MrWobot/hvps/Documents/Common resistor values.png

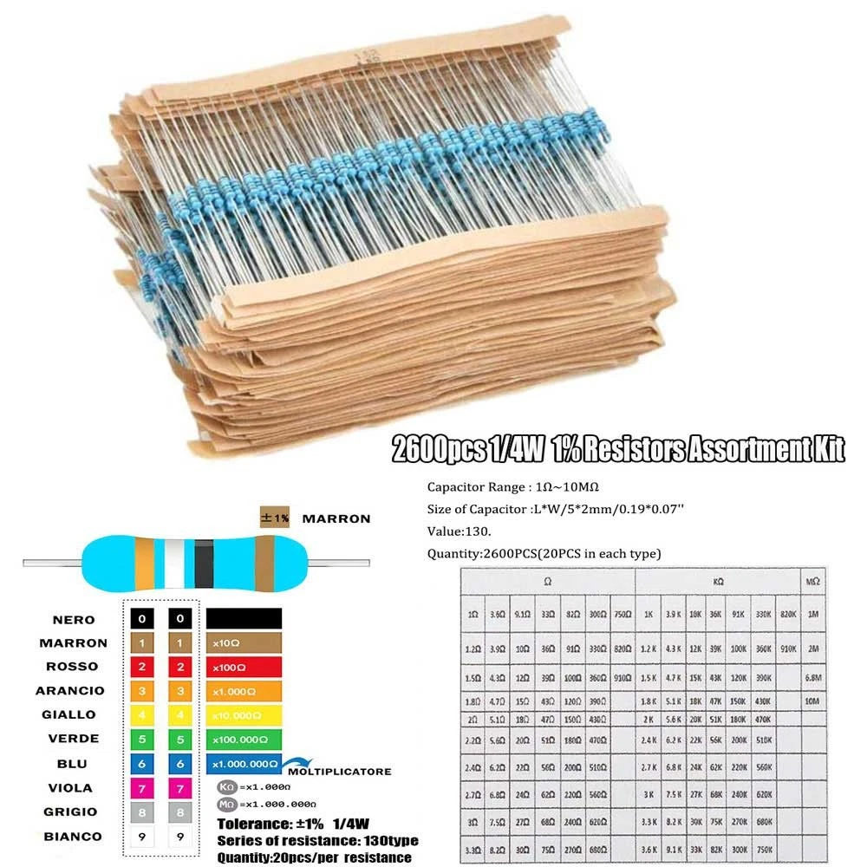
Documents/Common resistor values.png
