MrWobot/hvps/Code/C++/misc/ESP32-Pinout.webp

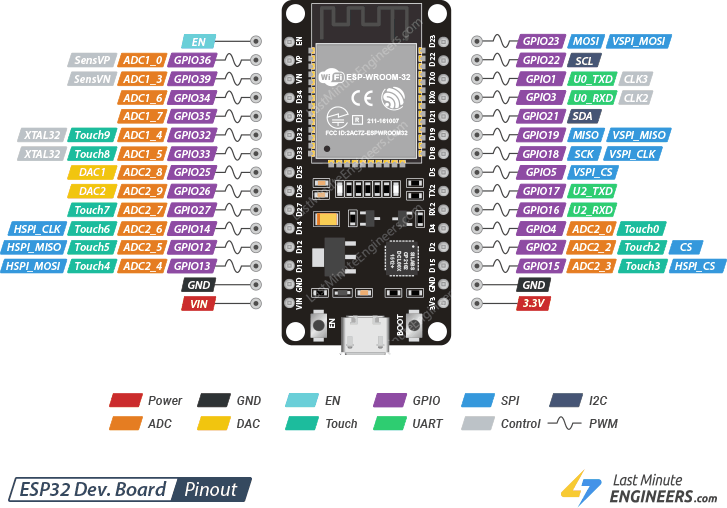
Code/C++/misc/ESP32-Pinout.webp
