MrWobot/hvps/Documents/ESP-FPGA Interface/Pins.png

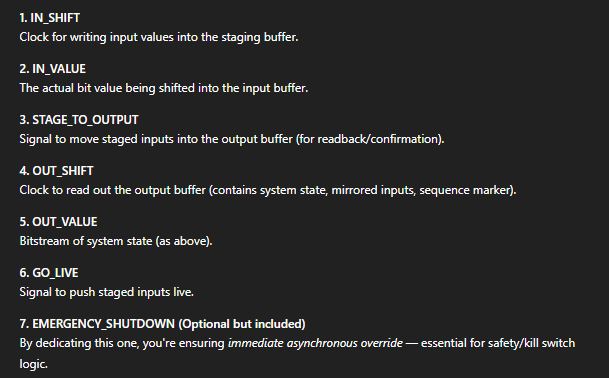
Documents/ESP-FPGA Interface/Pins.png
