MrWobot/hvps/Documents/Flyback Mismatch Ratio.png

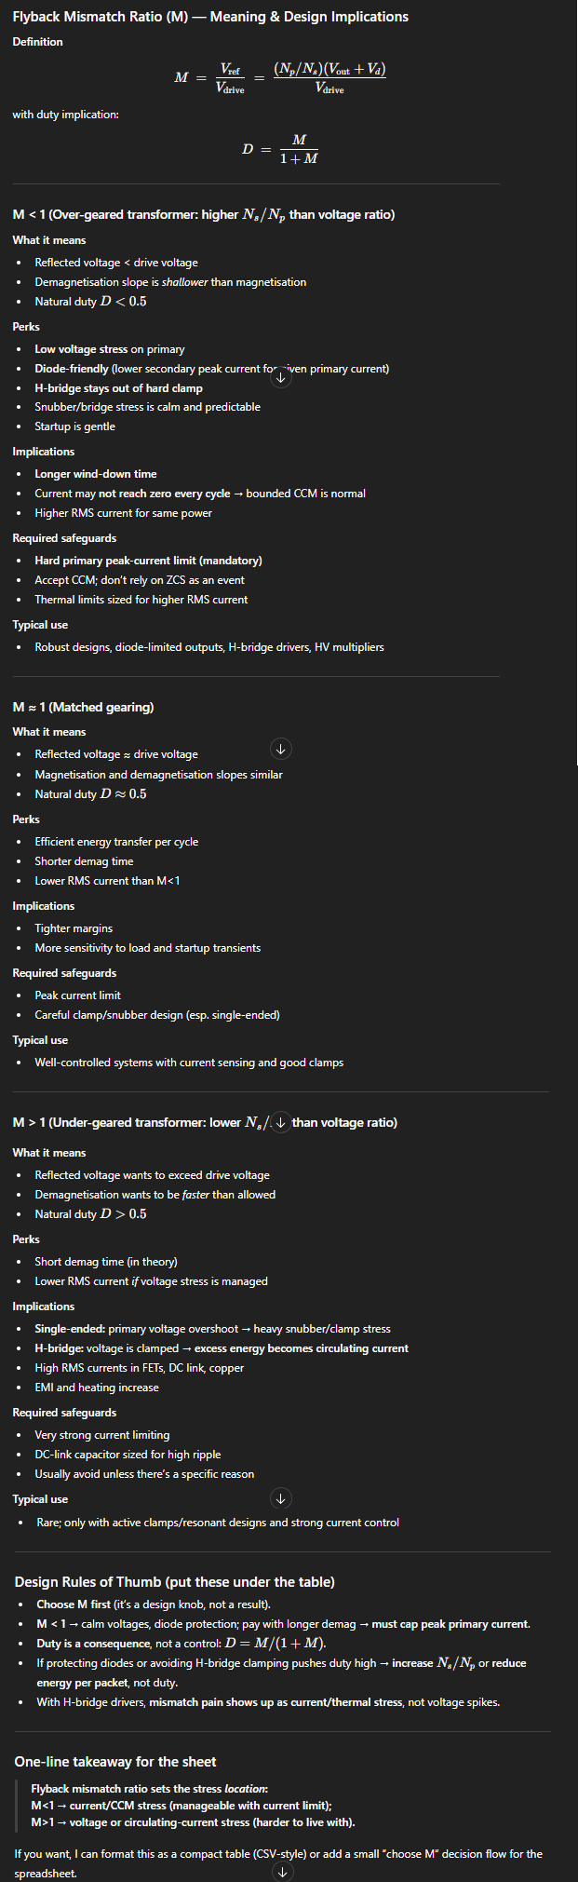
Documents/Flyback Mismatch Ratio.png
