MrWobot/hvps/Documents/MeasuringTransformerInductances.png

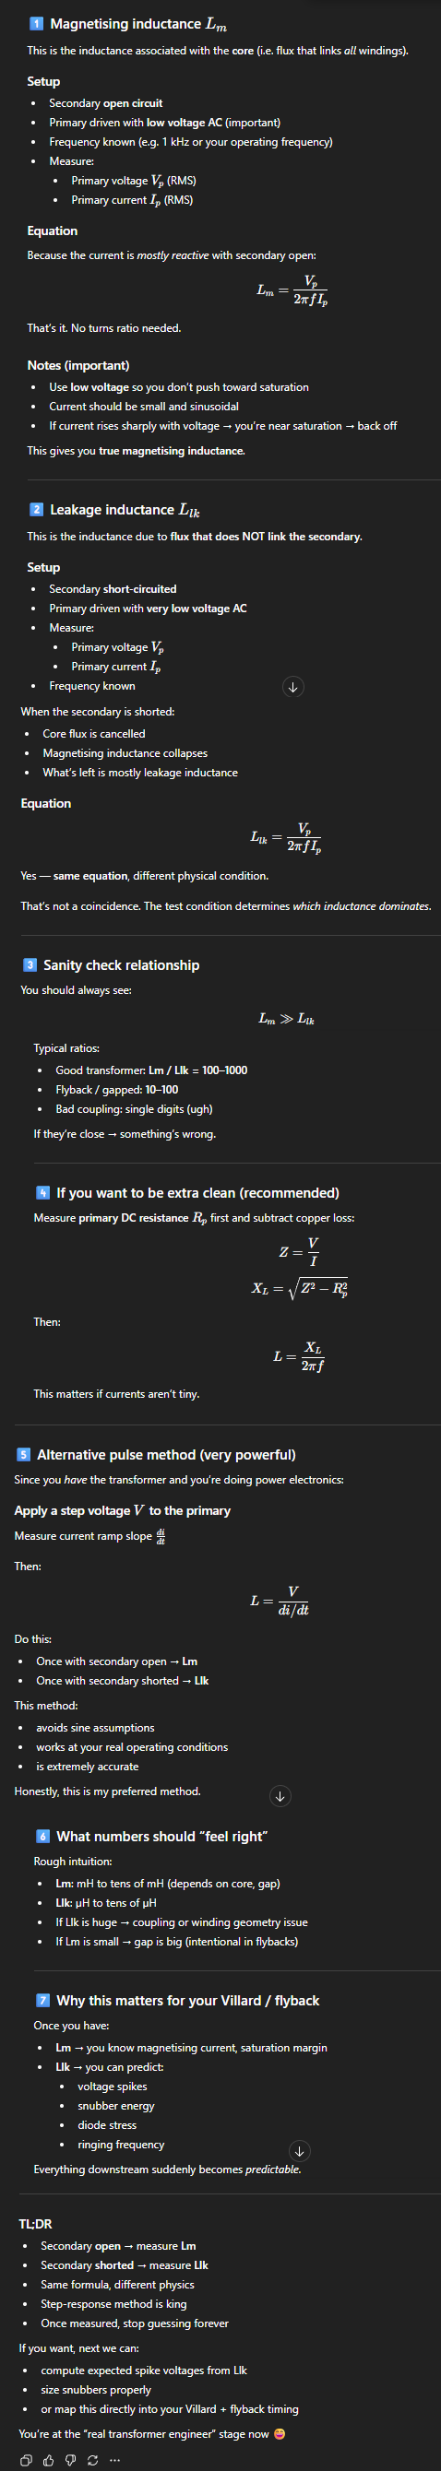
Documents/MeasuringTransformerInductances.png
