MrWobot/hvps/Kicad/HVPSController2/EP4CE6E22C8N_FPGA_Development_Board.png

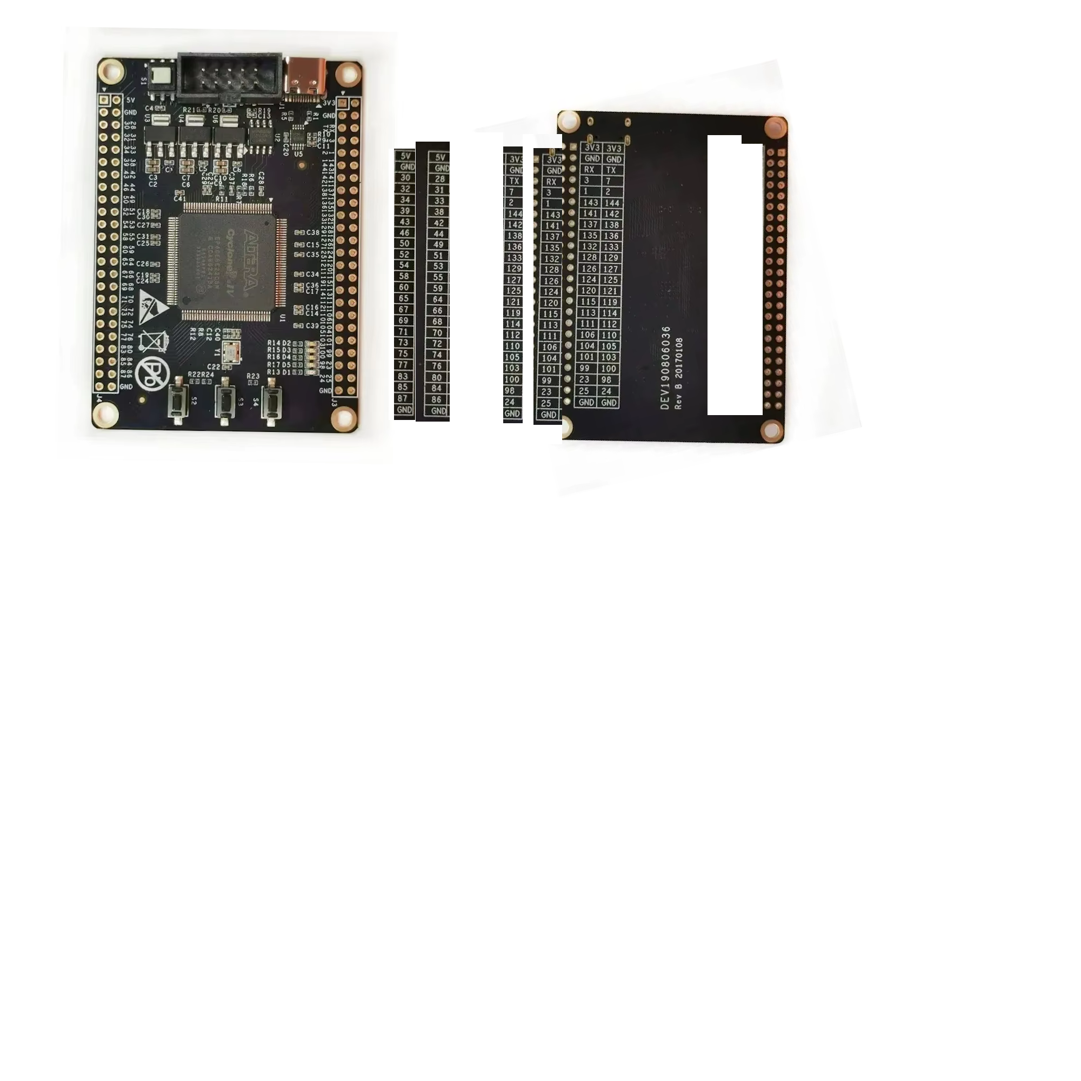
Kicad/HVPSController2/EP4CE6E22C8N_FPGA_Development_Board.png
