MrWobot/hvps/MATLAB/FullSimulation/FullSimulation.png

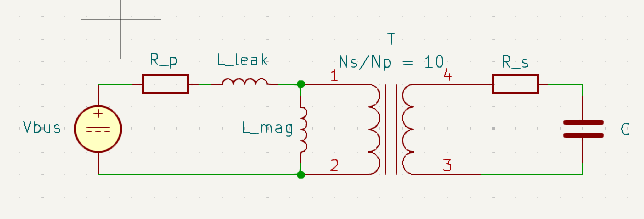
MATLAB/FullSimulation/FullSimulation.png
