MrWobot/hvps/Spreadsheets/Parts_HVPSController2.xlsx

Sheet: Sheet1
Subsystem | Reference | Ordered | Url | Include (green) | Part Name | Part Number | Category | Quantity Needed | Quantity in Stock | Description | Value/Rating | Tolerance | Voltage Rating | Power Rating | Package/Size | Supplier | Supplier Part Number | Unit Price | Total Cost | Lead Time | Notes
HVPSController2 | C1 | [/ | https://www.mouser.co.uk/ProductDetail/Chemi-Con/EKYB101ELL102MM40S?qs=IYueExuAvkrcoErCvSFiXg%3D%3D | ‎ | EKYB101ELL102MM40S | EKYB101ELL102MM40S |  |  |  | Aluminium Electrolytic Capacitors - Radial Leaded 100VDC 1000uF Tol 20% 18x40mm | 1000uF | 20% | 100v |  | 18x40mm | Mouser | 661-EKYB101E102MM40S | £1.79 | Total cost calculated as Quantity Needed × Unit Price. | Expected time for delivery from supplier. | Any additional notes, like alternatives or special instructions.
 | C2 | [/ | https://www.mouser.co.uk/ProductDetail/Chemi-Con/EKYB101ELL102MM40S?qs=IYueExuAvkrcoErCvSFiXg%3D%3D | ‎ | EKYB101ELL102MM40S | EKYB101ELL102MM40S |  |  |  | Aluminium Electrolytic Capacitors - Radial Leaded 100VDC 1000uF Tol 20% 18x40mm | 1000uF | 20% | 100v |  | 18x40mm | Mouser | 661-EKYB101E102MM40S | £1.79
 | C3 | [/ | https://www.mouser.co.uk/ProductDetail/Chemi-Con/EKYB101ELL102MM40S?qs=IYueExuAvkrcoErCvSFiXg%3D%3D | ‎ | EKYB101ELL102MM40S | EKYB101ELL102MM40S |  |  |  | Aluminium Electrolytic Capacitors - Radial Leaded 100VDC 1000uF Tol 20% 18x40mm | 1000uF | 20% | 100v |  | 18x40mm | Mouser | 661-EKYB101E102MM40S | £1.79
 | C4 | [/ | https://www.mouser.co.uk/ProductDetail/Chemi-Con/EKYB101ELL102MM40S?qs=IYueExuAvkrcoErCvSFiXg%3D%3D | ‎ | EKYB101ELL102MM40S | EKYB101ELL102MM40S |  |  |  | Aluminium Electrolytic Capacitors - Radial Leaded 100VDC 1000uF Tol 20% 18x40mm | 1000uF | 20% | 100v |  | 18x40mm | Mouser | 661-EKYB101E102MM40S | £1.79
 | C5 | [/ | https://www.mouser.co.uk/ProductDetail/Chemi-Con/EKYB101ELL102MM40S?qs=IYueExuAvkrcoErCvSFiXg%3D%3D | ‎ | EKYB101ELL102MM40S | EKYB101ELL102MM40S |  |  |  | Aluminium Electrolytic Capacitors - Radial Leaded 100VDC 1000uF Tol 20% 18x40mm | 1000uF | 20% | 100v |  | 18x40mm | Mouser | 661-EKYB101E102MM40S | £1.79
 | C6 | [/ | https://www.mouser.co.uk/ProductDetail/Chemi-Con/EKYB101ELL102MM40S?qs=IYueExuAvkrcoErCvSFiXg%3D%3D | ‎ | EKYB101ELL102MM40S | EKYB101ELL102MM40S |  |  |  | Aluminium Electrolytic Capacitors - Radial Leaded 100VDC 1000uF Tol 20% 18x40mm | 1000uF | 20% | 100v |  | 18x40mm | Mouser | 661-EKYB101E102MM40S | £1.79
 | C7 | [/ | https://www.mouser.co.uk/ProductDetail/Chemi-Con/EKYB101ELL102MM40S?qs=IYueExuAvkrcoErCvSFiXg%3D%3D | ‎ | EKYB101ELL102MM40S | EKYB101ELL102MM40S |  |  |  | Aluminium Electrolytic Capacitors - Radial Leaded 100VDC 1000uF Tol 20% 18x40mm | 1000uF | 20% | 100v |  | 18x40mm | Mouser | 661-EKYB101E102MM40S | £1.79
 | C8 | [/ | https://www.mouser.co.uk/ProductDetail/Chemi-Con/EKYB101ELL102MM40S?qs=IYueExuAvkrcoErCvSFiXg%3D%3D | ‎ | EKYB101ELL102MM40S | EKYB101ELL102MM40S |  |  |  | Aluminium Electrolytic Capacitors - Radial Leaded 100VDC 1000uF Tol 20% 18x40mm | 1000uF | 20% | 100v |  | 18x40mm | Mouser | 661-EKYB101E102MM40S | £1.79
 | C9 | [/ | https://www.mouser.co.uk/ProductDetail/Chemi-Con/EKYB101ELL102MM40S?qs=IYueExuAvkrcoErCvSFiXg%3D%3D | ‎ | EKYB101ELL102MM40S | EKYB101ELL102MM40S |  |  |  | Aluminium Electrolytic Capacitors - Radial Leaded 100VDC 1000uF Tol 20% 18x40mm | 1000uF | 20% | 100v |  | 18x40mm | Mouser | 661-EKYB101E102MM40S | £1.79
 | C10 | [/ | https://www.mouser.co.uk/ProductDetail/Chemi-Con/EKYB101ELL102MM40S?qs=IYueExuAvkrcoErCvSFiXg%3D%3D | ‎ | EKYB101ELL102MM40S | EKYB101ELL102MM40S |  |  |  | Aluminium Electrolytic Capacitors - Radial Leaded 100VDC 1000uF Tol 20% 18x40mm | 1000uF | 20% | 100v |  | 18x40mm | Mouser | 661-EKYB101E102MM40S | £1.79
 | C11 |  | https://www.aliexpress.com/item/1005002290441861.html?mp=1 | ‎ | Multilayer ceramic capacitor 50V 30pF capacitor | 300 30pF |  |  |  | 300 30oF NNKC capacitor | 30pF | 10% | 50v |  |  | Electronkit Official Store
 | C12 |  | https://www.aliexpress.com/item/1005002290441861.html?mp=1 | ‎ | Multilayer ceramic capacitor 50V 30pF capacitor | 300 30pF |  |  |  | 300 30oF NNKC capacitor | 30pF | 10% | 50v |  |  | Electronkit Official Store
 | C13 |  | https://www.aliexpress.com/item/1005002290441861.html?mp=1 | ‎ | Multilayer ceramic capacitor 50V 30pF capacitor | 300 30pF |  |  |  | 300 30oF NNKC capacitor | 30pF | 10% | 50v |  |  | Electronkit Official Store
 | C14 |  | https://www.aliexpress.com/item/1005002290441861.html?mp=1 | ‎ | Multilayer ceramic capacitor 50V 30pF capacitor | 300 30pF |  |  |  | 300 30oF NNKC capacitor | 30pF | 10% | 50v |  |  | Electronkit Official Store
 | C15 |  | https://www.aliexpress.com/item/1005002290441861.html?mp=1 | ‎ | Multilayer ceramic capacitor 50V 30pF capacitor | 300 30pF |  |  |  | 300 30oF NNKC capacitor | 30pF | 10% | 50v |  |  | Electronkit Official Store
 | C16 |  | https://www.aliexpress.com/item/1005002290441861.html?mp=1 | ‎ | Multilayer ceramic capacitor 50V 30pF capacitor | 300 30pF |  |  |  | 300 30oF NNKC capacitor | 30pF | 10% | 50v |  |  | Electronkit Official Store
 | C17 |  | https://www.aliexpress.com/item/1005002290441861.html?curPageLogUid=F0H9fgmOu6Th | ‎ | Multilayer ceramic capacitor 50V 100nF capacitor | 104 100nF |  |  |  | 104 100nF MMLC capacitor | 100nF | 10% | 50v |  |  | Electronkit Official Store
 | C18 |  | https://www.aliexpress.com/item/1005002290441861.html?curPageLogUid=F0H9fgmOu6Th | ‎ | Multilayer ceramic capacitor 50V 100nF capacitor | 104 100nF |  |  |  | 104 100nF MMLC capacitor | 100nF | 10% | 50v |  |  | Electronkit Official Store
 | C19 |  | https://www.aliexpress.com/item/1005002290441861.html?curPageLogUid=F0H9fgmOu6Th | ‎ | Multilayer ceramic capacitor 50V 100nF capacitor | 104 100nF |  |  |  | 104 100nF MMLC capacitor | 100nF | 10% | 50v |  |  | Electronkit Official Store
 | C20 |  | https://www.aliexpress.com/item/1005002290441861.html?curPageLogUid=F0H9fgmOu6Th | ‎ | Multilayer ceramic capacitor 50V 100nF capacitor | 104 100nF |  |  |  | 104 100nF MMLC capacitor | 100nF | 10% | 50v |  |  | Electronkit Official Store
 | C21 |  | https://www.aliexpress.com/item/1005002290441861.html?curPageLogUid=F0H9fgmOu6Th | ‎ | Multilayer ceramic capacitor 50V 100nF capacitor | 104 100nF |  |  |  | 104 100nF MMLC capacitor | 100nF | 10% | 50v |  |  | Electronkit Official Store
 | C22 |  | https://www.aliexpress.com/item/1005002290441861.html?curPageLogUid=F0H9fgmOu6Th | ‎ | Multilayer ceramic capacitor 50V 100nF capacitor | 104 100nF |  |  |  | 104 100nF MMLC capacitor | 100nF | 10% | 50v |  |  | Electronkit Official Store
 | C23 |  | https://www.aliexpress.com/item/1005002290441861.html?curPageLogUid=F0H9fgmOu6Th | ‎ | Multilayer ceramic capacitor 50V 100nF capacitor | 104 100nF |  |  |  | 104 100nF MMLC capacitor | 100nF | 10% | 50v |  |  | Electronkit Official Store
 | C24 |  | https://www.aliexpress.com/item/1005002290441861.html?curPageLogUid=F0H9fgmOu6Th | ‎ | Multilayer ceramic capacitor 50V 100nF capacitor | 104 100nF |  |  |  | 104 100nF MMLC capacitor | 100nF | 10% | 50v |  |  | Electronkit Official Store
 | C25 |  | https://www.aliexpress.com/item/1005002290441861.html?curPageLogUid=F0H9fgmOu6Th | ‎ | Multilayer ceramic capacitor 50V 100nF capacitor | 104 100nF |  |  |  | 104 100nF MMLC capacitor | 100nF | 10% | 50v |  |  | Electronkit Official Store
 | C26 |  | https://www.aliexpress.com/item/1005002290441861.html?curPageLogUid=F0H9fgmOu6Th | ‎ | Multilayer ceramic capacitor 50V 100nF capacitor | 104 100nF |  |  |  | 104 100nF MMLC capacitor | 100nF | 10% | 50v |  |  | Electronkit Official Store
 | C27 |  | https://www.aliexpress.com/item/1005002290441861.html?curPageLogUid=F0H9fgmOu6Th | ‎ | Multilayer ceramic capacitor 50V 100nF capacitor | 104 100nF |  |  |  | 104 100nF MMLC capacitor | 100nF | 10% | 50v |  |  | Electronkit Official Store
 | C28 | [/ | https://www.mouser.co.uk/ProductDetail/Chemi-Con/EKYB101ELL102MM40S?qs=IYueExuAvkrcoErCvSFiXg%3D%3D | ‎ | EKYB101ELL102MM40S | EKYB101ELL102MM40S |  |  |  | Aluminium Electrolytic Capacitors - Radial Leaded 100VDC 1000uF Tol 20% 18x40mm | 1000uF | 20% | 100v |  | 18x40mm | Mouser | 661-EKYB101E102MM40S | £1.79
 | C29 | [/ | https://www.mouser.co.uk/ProductDetail/Chemi-Con/EKYB101ELL102MM40S?qs=IYueExuAvkrcoErCvSFiXg%3D%3D | ‎ | EKYB101ELL102MM40S | EKYB101ELL102MM40S |  |  |  | Aluminium Electrolytic Capacitors - Radial Leaded 100VDC 1000uF Tol 20% 18x40mm | 1000uF | 20% | 100v |  | 18x40mm | Mouser | 661-EKYB101E102MM40S | £1.79
 | C30 | [/ | https://www.mouser.co.uk/ProductDetail/Chemi-Con/EKYB101ELL102MM40S?qs=IYueExuAvkrcoErCvSFiXg%3D%3D | ‎ | EKYB101ELL102MM40S | EKYB101ELL102MM40S |  |  |  | Aluminium Electrolytic Capacitors - Radial Leaded 100VDC 1000uF Tol 20% 18x40mm | 1000uF | 20% | 100v |  | 18x40mm | Mouser | 661-EKYB101E102MM40S | £1.79
 | C31 | [/ | https://www.mouser.co.uk/ProductDetail/Chemi-Con/EKYB101ELL102MM40S?qs=IYueExuAvkrcoErCvSFiXg%3D%3D | ‎ | EKYB101ELL102MM40S | EKYB101ELL102MM40S |  |  |  | Aluminium Electrolytic Capacitors - Radial Leaded 100VDC 1000uF Tol 20% 18x40mm | 1000uF | 20% | 100v |  | 18x40mm | Mouser | 661-EKYB101E102MM40S | £1.79
 | C32 | [/ | https://www.mouser.co.uk/ProductDetail/Chemi-Con/EKYB101ELL102MM40S?qs=IYueExuAvkrcoErCvSFiXg%3D%3D | ‎ | EKYB101ELL102MM40S | EKYB101ELL102MM40S |  |  |  | Aluminium Electrolytic Capacitors - Radial Leaded 100VDC 1000uF Tol 20% 18x40mm | 1000uF | 20% | 100v |  | 18x40mm | Mouser | 661-EKYB101E102MM40S | £1.79
 | C33 | [/ | https://www.mouser.co.uk/ProductDetail/Chemi-Con/EKYB101ELL102MM40S?qs=IYueExuAvkrcoErCvSFiXg%3D%3D | ‎ | EKYB101ELL102MM40S | EKYB101ELL102MM40S |  |  |  | Aluminium Electrolytic Capacitors - Radial Leaded 100VDC 1000uF Tol 20% 18x40mm | 1000uF | 20% | 100v |  | 18x40mm | Mouser | 661-EKYB101E102MM40S | £1.79
 | C34 | [/ | https://www.mouser.co.uk/ProductDetail/Chemi-Con/EKYB101ELL102MM40S?qs=IYueExuAvkrcoErCvSFiXg%3D%3D | ‎ | EKYB101ELL102MM40S | EKYB101ELL102MM40S |  |  |  | Aluminium Electrolytic Capacitors - Radial Leaded 100VDC 1000uF Tol 20% 18x40mm | 1000uF | 20% | 100v |  | 18x40mm | Mouser | 661-EKYB101E102MM40S | £1.79
 | C35 | [/ | https://www.mouser.co.uk/ProductDetail/Chemi-Con/EKYB101ELL102MM40S?qs=IYueExuAvkrcoErCvSFiXg%3D%3D | ‎ | EKYB101ELL102MM40S | EKYB101ELL102MM40S |  |  |  | Aluminium Electrolytic Capacitors - Radial Leaded 100VDC 1000uF Tol 20% 18x40mm | 1000uF | 20% | 100v |  | 18x40mm | Mouser | 661-EKYB101E102MM40S | £1.79
 | C36 | [/ | https://www.mouser.co.uk/ProductDetail/Chemi-Con/EKYB101ELL102MM40S?qs=IYueExuAvkrcoErCvSFiXg%3D%3D | ‎ | EKYB101ELL102MM40S | EKYB101ELL102MM40S |  |  |  | Aluminium Electrolytic Capacitors - Radial Leaded 100VDC 1000uF Tol 20% 18x40mm | 1000uF | 20% | 100v |  | 18x40mm | Mouser | 661-EKYB101E102MM40S | £1.79
 | C37 | [/ | https://www.mouser.co.uk/ProductDetail/Chemi-Con/EKYB101ELL102MM40S?qs=IYueExuAvkrcoErCvSFiXg%3D%3D | ‎ | EKYB101ELL102MM40S | EKYB101ELL102MM40S |  |  |  | Aluminium Electrolytic Capacitors - Radial Leaded 100VDC 1000uF Tol 20% 18x40mm | 1000uF | 20% | 100v |  | 18x40mm | Mouser | 661-EKYB101E102MM40S | £1.79
 | C38 | [/ | https://www.mouser.co.uk/ProductDetail/KYOCERA-AVX/SL155C472MAB | ‎ | SL155C472MAB | SL155C472MAB |  |  |  | Multilayer Ceramic Capacitors MLCC - Leaded SKYCAPS | 4.7uF | 10% | 50v |  |  | Mouser | 581-SL155C472MAB | £0.31
 | C39 |  |  | /
 | C40 | [/ | https://www.mouser.co.uk/ProductDetail/Vishay-BC-Components/K103K15X7RF5TK2?qs=sYfpZ29HcUSZbtKxC8Ci1g%3D%3D | ‎ | K103K15X7RF5TK2 | K103K15X7RF5TK2 |  |  |  | Multilayer Ceramic Capacitors MLCC - Leaded .1LS .01UF 50V 10% | 10nF | 10% | 50v |  |  | Mouser | 594-K103K15X7RF5TK2 | £0.18
 | C41 |  | https://www.mouser.co.uk/ProductDetail/Panasonic/ECA-1JM102?qs=EZwXiknEaqTHw%252BmBjjudqg%3D%3D | ‎ | ECA-1JM102 | ECA-1JM102 |  |  |  | Aluminium Electrolytic Capacitors - Radial Leaded 1000uF 63V | 1000uF | 20% | 63v |  |  | Mouser | 667-ECA-1JM102 | £0.68
 | C42 |  | https://www.mouser.co.uk/ProductDetail/KYOCERA-AVX/SR211C104KAATR1 | ‎ | SR211C104KAATR1 | SR211C104KAATR1 |  |  |  | Multilayer Ceramic Capacitors MLCC - Leaded 100V 0.1uF X7R Long Leads 1"min 10% A 581-SR211C104KARTR1 | 100nF | 10% | 100v |  |  | Mouser | 581-SR211C104KAATR1
 | C43 |  | https://www.mouser.co.uk/ProductDetail/Nichicon/UPW1E471MPD6TA?qs=%252Bj3bNAeznFUL2kyej8zyGg%3D%3D | ‎ | UPW1E471MPD6TA | UPW1E471MPD6TA |  |  |  | Aluminium Electrolytic Capacitors - Radial Leaded 470uF 20% 25V AEC-Q200 | 470uF | 20% | 25v |  |  | Mouser | 647-UPW1E471MPD6TA | £0.29
 | C44 |  | https://www.aliexpress.com/item/1005002290441861.html?curPageLogUid=F0H9fgmOu6Th | ‎ | Multilayer ceramic capacitor 50V 100nF capacitor | 104 100nF |  |  |  | 104 100nF MMLC capacitor | 100nF | 10% | 50v |  |  | Electronkit Official Store
 | C45 | [/ | https://www.mouser.co.uk/ProductDetail/KYOCERA-AVX/SR211C104KAATR1 | ‎ | SR211C104KAATR1 | SR211C104KAATR1 |  |  |  | Multilayer Ceramic Capacitors MLCC - Leaded 100V 0.1uF X7R Long Leads 1"min 10% A 581-SR211C104KARTR1 | 100nF | 10% | 100v |  |  | Mouser | 581-SR211C104KAATR1
 | C46 | [/ | https://www.mouser.co.uk/ProductDetail/KYOCERA-AVX/SR211C104KAATR1 | ‎ | SR211C104KAATR1 | SR211C104KAATR1 |  |  |  | Multilayer Ceramic Capacitors MLCC - Leaded 100V 0.1uF X7R Long Leads 1"min 10% A 581-SR211C104KARTR1 | 100nF | 10% | 100v |  |  | Mouser | 581-SR211C104KAATR1
 | C47 | [/ | https://www.mouser.co.uk/ProductDetail/TDK/FK16X7R1C106K?qs=zLBlM7QTTNo2fF6bge9DGw%3D%3D | ‎ | FK16X7R1C106K | FK16X7R1C106K |  |  |  | Multilayer Ceramic Capacitors MLCC - Leaded SUGGESTED ALTERNATE 810-FG16X7R1E106KRT6 | 10uF | 10% | 16v |  |  | Mouser | 810-FK16X7R1C106K | £0.38
 | C48 |  |  |  |  |  |  |  |  |  | 4.7nF
 | C49 |  | https://www.mouser.co.uk/ProductDetail/Panasonic/ECA-1JM102?qs=EZwXiknEaqTHw%252BmBjjudqg%3D%3D | ‎ | ECA-1JM102 | ECA-1JM102 |  |  |  | Aluminium Electrolytic Capacitors - Radial Leaded 1000uF 63V | 1000uF | 20% | 63v |  |  | Mouser | 667-ECA-1JM102 | £0.68
 | C50 |  | https://www.mouser.co.uk/ProductDetail/KYOCERA-AVX/SR211C104KAATR1 | ‎ | SR211C104KAATR1 | SR211C104KAATR1 |  |  |  | Multilayer Ceramic Capacitors MLCC - Leaded 100V 0.1uF X7R Long Leads 1"min 10% A 581-SR211C104KARTR1 | 100nF | 10% | 100v |  |  | Mouser | 581-SR211C104KAATR1
 | C51 |  | https://www.mouser.co.uk/ProductDetail/Nichicon/UPW1E471MPD6TA?qs=%252Bj3bNAeznFUL2kyej8zyGg%3D%3D | ‎ | UPW1E471MPD6TA | UPW1E471MPD6TA |  |  |  | Aluminium Electrolytic Capacitors - Radial Leaded 470uF 20% 25V AEC-Q200 | 470uF | 20% | 25v |  |  | Mouser | 647-UPW1E471MPD6TA | £0.29
 | C52 |  | https://www.aliexpress.com/item/1005002290441861.html?curPageLogUid=F0H9fgmOu6Th |  | Multilayer ceramic capacitor 50V 100nF capacitor | 104 100nF |  |  |  | 104 100nF MMLC capacitor | 100nF | 10% | 50v |  |  | Electronkit Official Store
 | C53
 | C54 | [/ | https://www.mouser.co.uk/ProductDetail/KYOCERA-AVX/SR211C104KAATR1 | ‎ | SR211C104KAATR1 | SR211C104KAATR1 |  |  |  | Multilayer Ceramic Capacitors MLCC - Leaded 100V 0.1uF X7R Long Leads 1"min 10% A 581-SR211C104KARTR1 | 100nF | 10% | 100v |  |  | Mouser | 581-SR211C104KAATR1
 | C55 | [/ | https://www.mouser.co.uk/ProductDetail/KYOCERA-AVX/SR211C104KAATR1 | ‎ | SR211C104KAATR1 | SR211C104KAATR1 |  |  |  | Multilayer Ceramic Capacitors MLCC - Leaded 100V 0.1uF X7R Long Leads 1"min 10% A 581-SR211C104KARTR1 | 100nF | 10% | 100v |  |  | Mouser | 581-SR211C104KAATR1
 | C56 | [/ | https://www.mouser.co.uk/ProductDetail/TDK/FK16X7R1C106K?qs=zLBlM7QTTNo2fF6bge9DGw%3D%3D | ‎ | FK16X7R1C106K | FK16X7R1C106K |  |  |  | Multilayer Ceramic Capacitors MLCC - Leaded SUGGESTED ALTERNATE 810-FG16X7R1E106KRT6 | 10uF | 10% | 16v |  |  | Mouser | 810-FK16X7R1C106K | £0.38
 | C57
 | C58 |  | https://www.mouser.co.uk/ProductDetail/Panasonic/ECA-1JM102?qs=EZwXiknEaqTHw%252BmBjjudqg%3D%3D | ‎ | ECA-1JM102 | ECA-1JM102 |  |  |  | Aluminium Electrolytic Capacitors - Radial Leaded 1000uF 63V | 1000uF | 20% | 63v |  |  | Mouser | 667-ECA-1JM102 | £0.68
 | C59 |  | https://www.mouser.co.uk/ProductDetail/KYOCERA-AVX/SR211C104KAATR1 | ‎ | SR211C104KAATR1 | SR211C104KAATR1 |  |  |  | Multilayer Ceramic Capacitors MLCC - Leaded 100V 0.1uF X7R Long Leads 1"min 10% A 581-SR211C104KARTR1 | 100nF | 10% | 100v |  |  | Mouser | 581-SR211C104KAATR1
 | C60 |  |  | ‎
 | C61 |  |  | ‎ |  |  |  |  |  |  |  |  |  |  |  | Mouser | 647-UPW1E471MPD6TA | £0.29
 | C62 |  | https://www.mouser.co.uk/ProductDetail/Nichicon/UPW1E471MPD6TA?qs=%252Bj3bNAeznFUL2kyej8zyGg%3D%3D | ‎ | UPW1E471MPD6TA | UPW1E471MPD6TA |  |  |  | Aluminium Electrolytic Capacitors - Radial Leaded 470uF 20% 25V AEC-Q200 | 470uF | 20% | 25v
 | C63 |  | https://www.aliexpress.com/item/1005002290441861.html?curPageLogUid=F0H9fgmOu6Th | ‎ | Multilayer ceramic capacitor 50V 100nF capacitor | 104 100nF |  |  |  | 104 100nF MMLC capacitor | 100nF | 10% | 50v |  |  | Electronkit Official Store
 | C64 | [/ | https://www.mouser.co.uk/ProductDetail/KYOCERA-AVX/SR211C104KAATR1 | ‎ | SR211C104KAATR1 | SR211C104KAATR1 |  |  |  | Multilayer Ceramic Capacitors MLCC - Leaded 100V 0.1uF X7R Long Leads 1"min 10% A 581-SR211C104KARTR1 | 100nF | 10% | 100v |  |  | Mouser | 581-SR211C104KAATR1
 | C65 | [/ | https://www.mouser.co.uk/ProductDetail/KYOCERA-AVX/SR211C104KAATR1 | ‎ | SR211C104KAATR1 | SR211C104KAATR1 |  |  |  | Multilayer Ceramic Capacitors MLCC - Leaded 100V 0.1uF X7R Long Leads 1"min 10% A 581-SR211C104KARTR1 | 100nF | 10% | 100v |  |  | Mouser | 581-SR211C104KAATR1
 | C66 | [/ | https://www.mouser.co.uk/ProductDetail/TDK/FK16X7R1C106K?qs=zLBlM7QTTNo2fF6bge9DGw%3D%3D | ‎ | FK16X7R1C106K | FK16X7R1C106K |  |  |  | Multilayer Ceramic Capacitors MLCC - Leaded SUGGESTED ALTERNATE 810-FG16X7R1E106KRT6 | 10uF | 10% | 16v |  |  | Mouser | 810-FK16X7R1C106K | £0.38
 | C67 | [/ | https://www.mouser.co.uk/ProductDetail/TDK/FG26X7R2A105KNT06?qs=qf2ddTMq67XO0I1H0ed67A%3D%3D | ‎ | FG26X7R2A105KNT06 | FG26X7R2A105KNT06 |  |  |  | Multilayer Ceramic Capacitors MLCC - Leaded RAD 100V 1uF X7R 10% LS:5mm | 1uF | 10% | 100v |  |  | Mouser | 810-FG26X7R2A105KNT6 | £0.56
 | C68 | [/ | https://www.mouser.co.uk/ProductDetail/TDK/FG26X7R2A105KNT06?qs=qf2ddTMq67XO0I1H0ed67A%3D%3D | ‎ | FG26X7R2A105KNT06 | FG26X7R2A105KNT06 |  |  |  | Multilayer Ceramic Capacitors MLCC - Leaded RAD 100V 1uF X7R 10% LS:5mm | 1uF | 10% | 100v |  |  | Mouser | 810-FG26X7R2A105KNT6 | £0.56
 | C69 |  | https://www.aliexpress.com/item/1005002290441861.html?curPageLogUid=F0H9fgmOu6Th | ‎ | Multilayer ceramic capacitor 50V 100nF capacitor | 104 100nF |  |  |  | 104 100nF MMLC capacitor | 100nF | 10% | 50v |  |  | Electronkit Official Store
 | C70 | [/ | https://www.mouser.co.uk/ProductDetail/TDK/FK16X7R1C106K?qs=zLBlM7QTTNo2fF6bge9DGw%3D%3D | ‎ | FK16X7R1C106K | FK16X7R1C106K |  |  |  | Multilayer Ceramic Capacitors MLCC - Leaded SUGGESTED ALTERNATE 810-FG16X7R1E106KRT6 | 10uF | 10% | 16v |  |  | Mouser | 810-FK16X7R1C106K | £0.38
 | C71 |  | https://www.aliexpress.com/item/1005002290441861.html?curPageLogUid=F0H9fgmOu6Th | ‎ | Multilayer ceramic capacitor 50V 100nF capacitor | 104 100nF |  |  |  | 104 100nF MMLC capacitor | 100nF | 10% | 50v |  |  | Electronkit Official Store
 | C72 | [/ | https://www.mouser.co.uk/ProductDetail/TDK/FK16X7R1C106K?qs=zLBlM7QTTNo2fF6bge9DGw%3D%3D | ‎ | FK16X7R1C106K | FK16X7R1C106K |  |  |  | Multilayer Ceramic Capacitors MLCC - Leaded SUGGESTED ALTERNATE 810-FG16X7R1E106KRT6 | 10uF | 10% | 16v |  |  | Mouser | 810-FK16X7R1C106K | £0.38
 | C73 | [/ | https://www.mouser.co.uk/ProductDetail/TDK/FG26X7R2A105KNT06?qs=qf2ddTMq67XO0I1H0ed67A%3D%3D | ‎ | FG26X7R2A105KNT06 | FG26X7R2A105KNT06 |  |  |  | Multilayer Ceramic Capacitors MLCC - Leaded RAD 100V 1uF X7R 10% LS:5mm | 1uF | 10% | 100v |  |  | Mouser | 810-FG26X7R2A105KNT6 | £0.56
 | C74 | [/ | https://www.mouser.co.uk/ProductDetail/TDK/FG26X7R2A105KNT06?qs=qf2ddTMq67XO0I1H0ed67A%3D%3D | ‎ | FG26X7R2A105KNT06 | FG26X7R2A105KNT06 |  |  |  | Multilayer Ceramic Capacitors MLCC - Leaded RAD 100V 1uF X7R 10% LS:5mm | 1uF | 10% | 100v |  |  | Mouser | 810-FG26X7R2A105KNT6 | £0.56
 | C75 |  |  | /
 | C76 |  |  | /
 | C77 |  |  | /
 | C78 |  |  | /
 | C81 |  | https://www.aliexpress.com/item/1005002290441861.html?curPageLogUid=F0H9fgmOu6Th | ‎ | Multilayer ceramic capacitor 50V 100nF capacitor | 104 100nF |  |  |  | 104 100nF MMLC capacitor | 100nF | 10% | 50v |  |  | Electronkit Official Store
 | C82 |  | https://www.aliexpress.com/item/1005002290441861.html?curPageLogUid=F0H9fgmOu6Th | ‎ | Multilayer ceramic capacitor 50V 100nF capacitor | 104 100nF |  |  |  | 104 100nF MMLC capacitor | 100nF | 10% | 50v |  |  | Electronkit Official Store
 | D1 |  |  |  | 1N4148 | 1n4148 |  |  |  | 1N4148
 | D2 |  |  |  | 1N4148 | 1n4148 |  |  |  | 1N4148
 | D3 |  |  |  | 1N4148 | 1n4148 |  |  |  | 1N4148
 | D4 | [/ | https://www.mouser.co.uk/ProductDetail/Vishay-Semiconductors/BZX55C3V0-TR?qs=WLTup5mM6hj0XdtrqBFixA%3D%3D3D | ‎ | BZX55C3V0-TR | BZX55C3V0-TR |  |  |  | Zener Diodes 3.0 Volt 0.5W 5% |  |  |  |  |  | Mouser | 78-BZX55C3V0
 | D5 |  | https://www.mouser.co.uk/ProductDetail/STMicroelectronics/1N5822?qs=JV7lzlMm3yJ50hlrGV6%252BnQ%3D%3D | ‎ | 1N5822 | 1N5822 |  |  |  | Schottky Diodes & Rectifiers Vr/40V Io/3A BULK |  |  |  |  |  | Mouser | 511-1N5822 | £0.21
 | D6 | [/ | https://www.mouser.co.uk/ProductDetail/onsemi/1N4149?qs=i4Fj9T%2FoRm%2FvLHm7C0TH8w%3D%3D | ‎ | 1N4149 | 1N4149 |  |  |  | Small Signal Switching Diodes Hi Conductance Fast |  |  |  |  |  | Mouser | 512-1N4149 | £0.07
 | D7 | [/ | https://www.mouser.co.uk/ProductDetail/onsemi/1N4149?qs=i4Fj9T%2FoRm%2FvLHm7C0TH8w%3D%3D | ‎ | 1N4149 | 1N4149 |  |  |  | Small Signal Switching Diodes Hi Conductance Fast |  |  |  |  |  | Mouser | 512-1N4149 | £0.07
 | D8 | [/ | https://www.mouser.co.uk/ProductDetail/onsemi/1N4149?qs=i4Fj9T%2FoRm%2FvLHm7C0TH8w%3D%3D | ‎ | 1N4149 | 1N4149 |  |  |  | Small Signal Switching Diodes Hi Conductance Fast |  |  |  |  |  | Mouser | 512-1N4149 | £0.07
 | D9 | [/ | https://www.mouser.co.uk/ProductDetail/onsemi/1N4149?qs=i4Fj9T%2FoRm%2FvLHm7C0TH8w%3D%3D | ‎ | 1N4149 | 1N4149 |  |  |  | Small Signal Switching Diodes Hi Conductance Fast |  |  |  |  |  | Mouser | 512-1N4149 | £0.07
 | D10 |  | https://www.mouser.co.uk/ProductDetail/STMicroelectronics/1N5822?qs=JV7lzlMm3yJ50hlrGV6%252BnQ%3D%3D | ‎ | 1N5822 | 1N5822 |  |  |  | Schottky Diodes & Rectifiers Vr/40V Io/3A BULK |  |  |  |  |  | Mouser | 511-1N5822 | £0.21
 | D11 | [/ | https://www.mouser.co.uk/ProductDetail/onsemi/1N4149?qs=i4Fj9T%2FoRm%2FvLHm7C0TH8w%3D%3D | ‎ | 1N4149 | 1N4149 |  |  |  | Small Signal Switching Diodes Hi Conductance Fast |  |  |  |  |  | Mouser | 512-1N4149 | £0.07
 | D12 | [/ | https://www.mouser.co.uk/ProductDetail/onsemi/1N4149?qs=i4Fj9T%2FoRm%2FvLHm7C0TH8w%3D%3D | ‎ | 1N4149 | 1N4149 |  |  |  | Small Signal Switching Diodes Hi Conductance Fast |  |  |  |  |  | Mouser | 512-1N4149 | £0.07
 | D13 |  | https://www.mouser.co.uk/ProductDetail/STMicroelectronics/1N5822?qs=JV7lzlMm3yJ50hlrGV6%252BnQ%3D%3D | ‎ | 1N5822 | 1N5822 |  |  |  | Schottky Diodes & Rectifiers Vr/40V Io/3A BULK |  |  |  |  |  | Mouser | 511-1N5822 | £0.21
 | D14 | [/ | https://www.mouser.co.uk/ProductDetail/Taiwan-Semiconductor/MUR420-R0?qs=dv9KMQQLqv0Mtply6g8TSg%3D%3D | ‎ | MUR420 R0 | MUR420 R0 |  |  |  | Rectifiers 25ns 4A 200V Ultra F ast Recovery Rect |  |  |  |  |  | Mouser | 821-MUR420R0 | £0.73
 | D15 | [/ | https://www.mouser.co.uk/ProductDetail/Taiwan-Semiconductor/MUR420-R0?qs=dv9KMQQLqv0Mtply6g8TSg%3D%3D | ‎ | MUR420 R0 | MUR420 R0 |  |  |  | Rectifiers 25ns 4A 200V Ultra F ast Recovery Rect |  |  |  |  |  | Mouser | 821-MUR420R0 | £0.73
 | D16 |  |  |  | 1N4148 | 1n4148 |  |  |  | 1N4148
 | F1 | [/ | https://www.mouser.co.uk/ProductDetail/Essentra/FH-320-NV?qs=PzGy0jfpSMtU9GQhdYJRvA%3D%3D | ‎ | FH-320-NV | FH-320-NV |  |  |  | Fuse Holder Accessories Fuse Holder,Black,5X20 Fuse |  |  |  |  |  | Mouser | 144-FH-320-NV | £0.72
 | H1 | [/ | https://www.mouser.co.uk/ProductDetail/Wakefield-Thermal/647-25ABPE?qs=1%252ByrAFyf4wEF4vm1j%252Byz0w%3D%3D | ‎ | 647-25ABPE | 647-25ABPE |  |  |  | Heat Sinks High Performance Heat Sink for Vertical Board Mounting for TO-220, 63.5mm Height |  |  |  |  |  | Mouser | 567-647-25ABPE | £2.55
 | H2 | [/ | https://www.mouser.co.uk/ProductDetail/Wakefield-Thermal/647-25ABPE?qs=1%252ByrAFyf4wEF4vm1j%252Byz0w%3D%3D | ‎ | 647-25ABPE | 647-25ABPE |  |  |  | Heat Sinks High Performance Heat Sink for Vertical Board Mounting for TO-220, 63.5mm Height |  |  |  |  |  | Mouser | 567-647-25ABPE | £2.55
 | H3 | [/ | https://www.mouser.co.uk/ProductDetail/Wakefield-Thermal/647-25ABPE?qs=1%252ByrAFyf4wEF4vm1j%252Byz0w%3D%3D | ‎ | 647-25ABPE | 647-25ABPE |  |  |  | Heat Sinks High Performance Heat Sink for Vertical Board Mounting for TO-220, 63.5mm Height |  |  |  |  |  | Mouser | 567-647-25ABPE | £2.55
 | H4 | [/ | https://www.mouser.co.uk/ProductDetail/Wakefield-Thermal/647-25ABPE?qs=1%252ByrAFyf4wEF4vm1j%252Byz0w%3D%3D | ‎ | 647-25ABPE | 647-25ABPE |  |  |  | Heat Sinks High Performance Heat Sink for Vertical Board Mounting for TO-220, 63.5mm Height |  |  |  |  |  | Mouser | 567-647-25ABPE | £2.55
 | H5 | [ | https://www.aliexpress.com/ssr/300000512/BundleDeals2?productIds=4000190314199:10000000710306628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 |  | TO-220 Cooling Radiator Aluminum Sheet | TO-220 Cooling Radiator Aluminum Sheet |  |  |  | TO-220 Cooling Radiator Aluminum Sheet |  |  |  |  |  | Aliexpress:Shenzhen DANTEQI Technology
 | H6 | [ | https://www.aliexpress.com/ssr/300000512/BundleDeals2?productIds=4000190314199:10000000710306628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 |  | TO-220 Cooling Radiator Aluminum Sheet | TO-220 Cooling Radiator Aluminum Sheet |  |  |  | TO-220 Cooling Radiator Aluminum Sheet |  |  |  |  |  | Aliexpress:Shenzhen DANTEQI Technology
 | H7 | [ | https://www.aliexpress.com/ssr/300000512/BundleDeals2?productIds=4000190314199:10000000710306628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 |  | TO-220 Cooling Radiator Aluminum Sheet | TO-220 Cooling Radiator Aluminum Sheet |  |  |  | TO-220 Cooling Radiator Aluminum Sheet |  |  |  |  |  | Aliexpress:Shenzhen DANTEQI Technology
 | J1 | [/] | https://www.aliexpress.com/item/1005007001183779.html?mp=1 | ‎ | PCB-3 (M4)PCB soldering terminal | PCB-3 (M4)PCB soldering terminal |  |  |  | PCB-3 (M4)PCB soldering terminal |  |  |  |  |  | Aliexpress:Shenzhen DANTEQI Technology | Shenzhen DANTEQI Technology | £1.25
 | J2 | [/] | https://www.aliexpress.com/item/1005007001183779.html?mp=1 | ‎ | PCB-3 (M4)PCB soldering terminal | PCB-3 (M4)PCB soldering terminal |  |  |  | PCB-3 (M4)PCB soldering terminal |  |  |  |  |  | Aliexpress:Shenzhen DANTEQI Technology | Shenzhen DANTEQI Technology | £1.25
 | J3
 | J4 | [?] | https://www.aliexpress.com/item/1005008559565009.html | ‎ | 8 2.54mm pin strip female | 8 2.54mm pin strip female |  |  |  | 8 2.54mm pin strip female |  |  |  |  |  | Aliexpress:Stlxy Store (Trader)
 | J5
 | J6
 | J7 |  | https://www.aliexpress.com/item/1005009262194204.html?curPageLogUid=su5Bbxdvt4nS |  | 10 pin JTAG Connector | 10 pin JTAG Connector |  |  |  | 10 pin JTAG Connector |  |  |  |  |  | Aliexpress:Stlxy Store (Trader) | Stlxy Store (Trader) | £2.17
 | J8 | [/] | https://www.aliexpress.com/item/1005008694962372.html?curPageLogUid=cfBDucwPxlF8 | ‎ | 4 pin JST XH2.54 female | 4 pin JST XH2.54 female |  |  |  | 4 pin JST XH2.54 female
 | J9 | [/] | https://www.aliexpress.com/item/1005007001183779.html?mp=1 | ‎ | PCB-1 (M4)PCB soldering terminal | PCB-1 (M4)PCB soldering terminal |  |  |  | PCB-1 (M4)PCB soldering terminal |  |  |  |  |  | Aliexpress:Shenzhen DANTEQI Technology | Shenzhen DANTEQI Technology
 | J10 |  |  | /
 | J11 | [?] | https://www.aliexpress.com/item/1005008694962372.html?curPageLogUid=cfBDucwPxlF8 | ‎ | 5 2.54mm pin strip female | 5 2.54mm pin strip female |  |  |  | 5 2.54mm pin strip female
 | J12 | [?] | https://www.aliexpress.com/item/1005008694962372.html?curPageLogUid=cfBDucwPxlF8 | ‎ | 5 2.54mm pin strip female | 5 2.54mm pin strip female |  |  |  | 5 2.54mm pin strip female
 | J13 | [/] | https://www.aliexpress.com/item/1005007001183779.html?mp=1 | ‎ | PCB-3 (M4)PCB soldering terminal | PCB-3 (M4)PCB soldering terminal |  |  |  | PCB-3 (M4)PCB soldering terminal |  |  |  |  |  | Aliexpress:Shenzhen DANTEQI Technology | Shenzhen DANTEQI Technology | £1.25
 | J14 | [/] | https://www.aliexpress.com/item/1005007001183779.html?mp=1 | ‎ | PCB-3 (M4)PCB soldering terminal | PCB-3 (M4)PCB soldering terminal |  |  |  | PCB-3 (M4)PCB soldering terminal |  |  |  |  |  | Aliexpress:Shenzhen DANTEQI Technology | Shenzhen DANTEQI Technology | £1.25
 | J15 | [/] | https://www.aliexpress.com/item/1005007001183779.html?mp=1 | ‎ | PCB-1 (M4)PCB soldering terminal | PCB-1 (M4)PCB soldering terminal |  |  |  | PCB-1 (M4)PCB soldering terminal |  |  |  |  |  | Aliexpress:Shenzhen DANTEQI Technology | Shenzhen DANTEQI Technology
 | J16 |  |  | /
 | J17 | [/] | https://www.aliexpress.com/item/1005008694962372.html?curPageLogUid=cfBDucwPxlF8 | ‎ | 2 pin JST XH2.54 female | 2 pin JST XH2.54 female |  |  |  | 2 pin JST XH2.54 female |  |  |  |  |  | Aliexpress:Stlxy Store (Trader)
 | J18 |  |  | /
 | J19 |  |  | /
 | J20 |  |  | /
 | J21 |  |  | /
 | J22 |  |  | /
 | J23 |  |  | /
 | J24 | [/] | https://www.aliexpress.com/item/1005008694962372.html?curPageLogUid=cfBDucwPxlF8 | ‎ | 2 pin JST XH2.54 female | 2 pin JST XH2.54 female |  |  |  | 2 pin JST XH2.54 female |  |  |  |  |  | Aliexpress:Stlxy Store (Trader)
 | J25 |  |  | /
 | J26 |  |  | /
 | J27 |  |  | /
 | J28 |  |  | /
 | J29 |  |  | /
 | J30 |  |  | /
 | J31 |  |  | /
 | J32 |  |  | /
 | J33 |  |  | /
 | J34 |  |  | /
 | J35 |  |  | /
 | J36 |  |  | /
 | K1 | [/] |  |  | AWHSH124D00G/ SRD-24VDC-SL-C | AWHSH124D00G/SRD-24VDC-SL-C |  |  |  | General Purpose Relays Commercial RelayRated Carrying Current :15AType of Sealing : Sealed and Waterproof TypeNumber of pole : one poleCoil Voltage : 24VCoil Type : Standard DC CoilContact Form : Form C | 15A |  | 24v |  |  | Mouser | 523-AWHSH124D00G | £0.76
 | K2 | [/] |  |  | AWHSH124D00G/ SRD-24VDC-SL-C | AWHSH124D00G/SRD-24VDC-SL-C |  |  |  | General Purpose Relays Commercial RelayRated Carrying Current :15AType of Sealing : Sealed and Waterproof TypeNumber of pole : one poleCoil Voltage : 24VCoil Type : Standard DC CoilContact Form : Form C | 10A |  | 24v |  |  | Mouser | 523-AWHSH124D00G | £0.76
 | K3 | [/] |  |  | SRD-05VDC-SL-C | SRD-05VDC-SL-C |  |  |  | 5v relay
 | L1 | [/] | https://www.mouser.co.uk/ProductDetail/Coilcraft/SER2918H-223KL?qs=zCSbvcPd3pbugGZO%2F8SqDw%3D%3D | ‎ | SER2918H-223KL | SER2918H-223KL |  |  |  | Power Inductors - SMD 22uH Shld 20% 28A 2.86mOhms AECQ2 |  |  | 28A |  |  | Mouser | 994-SER2918H-223KL
 | L2 | [/]
 | L3 | [/]
 | L4 | [/]
 | L5
 | OR1 | [/] |  |  | DLR2111 | DLR2111 |  |  |  | DLR2111
 | OR2 | [/] |  |  | DLR2111 | DLR2111 |  |  |  | DLR2111
 | OR3 | [/] |  |  | DLR2111 | DLR2111 |  |  |  | DLR2111
 | OR4 | [/] |  |  | DLR2111 | DLR2111 |  |  |  | DLR2111
 | OR5 | [/] |  |  | DLR2111 | DLR2111 |  |  |  | DLR2111
 | OT1 | [/] |  |  | DLT2111 | DLT2111 |  |  |  | DLT2111
 | OT2 | [/] |  |  | DLT2111 | DLT2111 |  |  |  | DLT2111
 | OT3 | [/] |  |  | DLT2111 | DLT2111 |  |  |  | DLT2111
 | OT4 | [/] |  |  | DLT2111 | DLT2111 |  |  |  | DLT2111
 | OT5 | [/] |  |  | DLT2111 | DLT2111 |  |  |  | DLT2111
 | R1 | [?] | https://www.aliexpress.com/item/1005003628962029.html?mp=1 | ‎ | 100W33RJ | 100W33RJ |  | 1 | ? | 100W high power winding resistor 33R Ohm 5% aluminum shell resistor | 33Ω | 5% |  | 100w |  | twjohm | 100W33RJ | ￡1.31
 | R2 | [/] | https://www.mouser.co.uk/ProductDetail/Vishay-BC-Components/MRS25000C1331FCT00?qs=pfd5qewlna4cepNSsorfFg%3D%3D | ‎ | Metal Film Resistors - Through Hole 0.6watt 1.33Kohm 1% | MRS25000C1331FCT00 |  |  | 0 | Metal Film Resistors - Through Hole 0.6watt 1.33Kohm 1% | 1.33KΩ |  |  |  |  | Mouser | MRS25000C1331FCT00 | £0.16 | £0.00
 | R3 |  |  |  | Generic 0.25w resistor | Generic 0.25w resistor |  |  |  | Generic 33K 0.25w resistor | 33KΩ | 1% |  | 0.25w |  | Aliexpress
 | R4 |  |  |  | Generic 0.25w resistor | Generic 0.25w resistor |  |  |  | Generic 1K 0.25w resistor | 1KΩ | 1% |  | 0.25w |  | Aliexpress
 | R5 |  |  |  | Generic 0.25w resistor | Generic 0.25w resistor |  |  |  | Generic 1K 0.25w resistor | 1KΩ | 1% |  | 0.25w |  | Aliexpress
 | R6 |  |  |  | Generic 0.25w resistor | Generic 0.25w resistor |  |  |  | Generic 2K 0.25w resistor | 2KΩ | 1% |  | 0.25w |  | Aliexpress
 | R7 | [/] | https://www.mouser.co.uk/ProductDetail/Vishay-BC-Components/MRS25000C1331FCT00?qs=pfd5qewlna4cepNSsorfFg%3D%3D | ‎ | Metal Film Resistors - Through Hole 0.6watt 1.33Kohm 1% | MRS25000C1331FCT00 |  |  | 0 | Metal Film Resistors - Through Hole 0.6watt 1.33Kohm 1% | 1.33KΩ |  |  |  |  | Mouser | MRS25000C1331FCT00 | £0.16 | £0.00
 | R8 |  |  | ‎ | Generic 0.25w resistor | Generic 0.25w resistor |  |  |  | Generic 10K 0.25w resistor | 10KΩ | 1% |  | 0.25w |  | Aliexpress
 | R9 |  |  | /
 | R10 |  |  | /
 | R11 |  |  |  | Generic 0.25w resistor | Generic 0.25w resistor |  |  |  | Generic 1K 0.25w resistor | 1KΩ | 1% |  | 0.25w |  | Aliexpress
 | R12 |  |  | ‎ | Generic 0.25w resistor | Generic 0.25w resistor |  |  |  | Generic 10K 0.25w resistor | 2KΩ | 1% |  | 0.25w |  | Aliexpress
 | R13 |  |  |  | Generic 0.25w resistor | Generic 0.25w resistor |  |  |  | Generic 120K 0.25w resistor | 120KΩ | 1% |  | 0.25w |  | Aliexpress
 | R14 |  |  |  | Generic 0.25w resistor | Generic 0.25w resistor |  |  |  | Generic 1K 0.25w resistor | 1KΩ | 1% |  | 0.25w |  | Aliexpress
 | R15 |  |  | ‎ | Generic 0.25w resistor | Generic 0.25w resistor |  |  |  | Generic 10K 0.25w resistor | 2KΩ | 1% |  | 0.25w |  | Aliexpress
 | R16 | [/ |  |  | SL2TTED10R0F | SL2TTED10R0F |  |  |  | Current Sense Resistors - SMD 2W 10 Ohm 1% 100ppm | 10Ω | 1% |  | 2w |  | Mouser | 660-SL2TTED10R0F | £1.61
 | R17 |  |  |  | Generic 0.25w resistor | Generic 0.25w resistor |  |  |  | Generic 51 0.25w resistor | 51Ω | 1% |  | 0.25w |  | Aliexpress
 | R18 |  |  |  | Generic 0.25w resistor | Generic 0.25w resistor |  |  |  | Generic 100 0.25w resistor | 100Ω | 1% |  | 0.25w |  | Aliexpress
 | R19 |  |  |  | Generic 0.25w resistor | Generic 0.25w resistor |  |  |  | Generic 1K 0.25w resistor | 1KΩ | 1% |  | 0.25w |  | Aliexpress
 | R20 |  |  |  | Generic 0.25w resistor | Generic 0.25w resistor |  |  |  | Generic 2K 0.25w resistor | 2KΩ | 1% |  | 0.25w |  | Aliexpress
 | R21 |  |  |  | Generic 0.25w resistor | Generic 0.25w resistor |  |  |  | Generic 4.7 0.25w resistor | 4.7Ω | 1% |  | 0.25w |  | Aliexpress
 | R22 |  |  |  | Generic 0.25w resistor | Generic 0.25w resistor |  |  |  | Generic 4.7 0.25w resistor | 4.7Ω | 1% |  | 0.25w |  | Aliexpress
 | R23 |  |  |  | Generic 0.25w resistor | Generic 0.25w resistor |  |  |  | Generic 1K 0.25w resistor | 1KΩ | 1% |  | 0.25w |  | Aliexpress
 | R24 |  |  |  | Generic 0.25w resistor | Generic 0.25w resistor |  |  |  | Generic 1K 0.25w resistor | 1KΩ | 1% |  | 0.25w |  | Aliexpress
 | R25 |  |  | /
 | R26 |  |  | /
 | R27 |  |  |  | Generic 0.25w resistor | Generic 0.25w resistor |  |  |  | 22K 0.25w resistor | 22K | 1% |  | 0.25w |  | Aliexpress
 | R28 |  |  |  | Generic 0.25w resistor | Generic 0.25w resistor |  |  |  | Generic 1K 0.25w resistor | 1KΩ | 1% |  | 0.25w |  | Aliexpress
 | R29 |  |  |  | Generic 0.25w resistor | Generic 0.25w resistor |  |  |  | Generic 10K 0.25w resistor | 10KΩ | 1% |  | 0.25w |  | Aliexpress
 | R30 |  |  |  | Generic 0.25w resistor | Generic 0.25w resistor |  |  |  | Generic 4.7 0.25w resistor | 4.7Ω | 1% |  | 0.25w |  | Aliexpress
 | R31 |  |  |  | Generic 0.25w resistor | Generic 0.25w resistor |  |  |  | Generic 4.7 0.25w resistor | 4.7Ω | 1% |  | 0.25w |  | Aliexpress
 | R32 |  |  | /
 | R33 |  |  | /
 | R34 |  |  |  | Generic 0.25w resistor | Generic 0.25w resistor |  |  |  | Generic 1K 0.25w resistor | 1KΩ | 1% |  | 0.25w |  | Aliexpress
 | R35 |  |  |  | Generic 0.25w resistor | Generic 0.25w resistor |  |  |  | Generic 1K 0.25w resistor | 1KΩ | 1% |  | 0.25w |  | Aliexpress
 | R36 |  |  |  | Generic 0.25w resistor | Generic 0.25w resistor |  |  |  | Generic 4.7 0.25w resistor | 4.7Ω | 1% |  | 0.25w |  | Aliexpress
 | R37
 | RV1
 | RV2
 | RV3
 | RV4 |  |  |  | Generic 0.5w variable resistor | Generic 0.5w variable resistor |  |  |  | Generic 10K 0.5w variable resistor | 10KΩ | 10% |  | 0.5w |  | Aliexpress
 | RV5 |  |  |  | Generic 0.5w variable resistor | Generic 0.5w variable resistor |  |  |  | Generic 5K 0.5w variable resistor | 5KΩ | 10% |  | 0.5w |  | Aliexpress
 | S2 |  | https://www.aliexpress.com/item/1005005531658132.html?mp=1 |  | MSS-04A | MSS-04A |  |  |  | MSS-04A |  |  |  |  |  | Aliexpress | MSS-04A | £0.13
 | T1 |  | https://www.coilcraft.com/en-us/products/transformers/power-transformers/current-sensing/cst2020/cst2020-200l/ |  | CST2020-200L | CST2020-200L |  |  |  | 200:1 current transformer |  |  |  |  |  | CoilCraft | CST2020-200L
 | U1 | [?] |  |  | 2N7000 | 2N7000 |  |  |  | 2N7000 |  |  |  |  |  | Aliexpress
 | U2 | [/] | https://www.aliexpress.com/item/1005008216457372.html |  | ESP32 | ESP32 |  |  |  | ESP32 Development CP2102 Board WiFi+Bluetooth |  |  |  |  |  | Aliexpress
 | U3 |  | https://www.aliexpress.com/item/1005006982300493.html |  | LM2596 LM2596HVS power supply module DC-DC BUCK 3A | LM2596 LM2596HVS power supply module DC-DC BUCK 3A |  |  |  |  |  |  |  |  |  | Aliexpress |  | £1.21
 | U4 | [/] | https://www.mouser.co.uk/ProductDetail/Texas-Instruments/LM4040A20IDBZR?qs=VBduBm9rCJS7ix0kTeCDJA%3D%3D |  | LM4040A20IDBZR | LM4040A20IDBZR |  |  |  | LM4040A20IDBZR 2.048v reference |  | 0.l% | 2.048v |  |  | Mouser | 595-LM4040A20IDBZR | £1.42
 | U5 |  | https://www.mouser.co.uk/ProductDetail/Analog-Devices/AD7822BNZ?qs=%2FtpEQrCGXCyXv71BkCSjyQ%3D%3D |  | AD7822BNZ | AD7822BNZ |  |  |  | AD7822BNZ |  |  |  |  |  | Mouser | 584-AD7822BNZ | £16.75
 | U6 | [/] | https://www.aliexpress.com/item/1005010771301622.html?curPageLogUid=bhGa5rS273EV |  | LM2956HVT-ADJ | LM2956HVT-ADJ |  |  |  | LM2956HVT-ADJ adjustable regulator |  |  |  |  |  | Aliexpress
 | U7 | [/] | https://www.mouser.co.uk/ProductDetail/Texas-Instruments/LM4040A20IDBZR?qs=VBduBm9rCJS7ix0kTeCDJA%3D%3D |  | LM4040A20IDBZR | LM4040A20IDBZR |  |  |  | LM4040A20IDBZR 2.048v reference |  | 0.l% | 2.048v |  |  | Mouser | 595-LM4040A20IDBZR | £1.42
 | U8 | [/] | https://www.aliexpress.com/item/1005005871456289.html |  | WS2812D | WS2812D |  |  |  | Programmable RGB LED |  |  |  |  |  | Aliexpress |  | ￡4.12
 | U9 | [/] | https://www.aliexpress.com/item/1005005871456289.html |  | WS2812D | WS2812D |  |  |  | Programmable RGB LED |  |  |  |  |  | Aliexpress |  | ￡4.12
 | U10 | [/] | https://www.aliexpress.com/item/1005005871456289.html |  | WS2812D | WS2812D |  |  |  | Programmable RGB LED |  |  |  |  |  | Aliexpress |  | ￡4.12
 | U11 | [/] | https://www.aliexpress.com/item/1005005871456289.html |  | WS2812D | WS2812D |  |  |  | Programmable RGB LED |  |  |  |  |  | Aliexpress |  | ￡4.12
 | U12 |  | https://www.mouser.co.uk/ProductDetail/Analog-Devices/AD7822BNZ?qs=%2FtpEQrCGXCyXv71BkCSjyQ%3D%3D |  | AD7822BNZ | AD7822BNZ |  |  |  | AD7822BNZ |  |  |  |  |  | Mouser | 584-AD7822BNZ | £16.75
 | U13 | [/] | https://www.aliexpress.com/item/1005005871456289.html |  | WS2812D | WS2812D |  |  |  | Programmable RGB LED |  |  |  |  |  | Aliexpress |  | ￡4.12
 | U14 | [/] | https://www.aliexpress.com/item/1005005871456289.html |  | WS2812D | WS2812D |  |  |  | Programmable RGB LED |  |  |  |  |  | Aliexpress |  | ￡4.12
 | U15 | [/] | https://www.aliexpress.com/item/1005005871456289.html |  | WS2812D | WS2812D |  |  |  | Programmable RGB LED |  |  |  |  |  | Aliexpress |  | ￡4.12
 | U16 | [/] | https://www.aliexpress.com/item/1005005871456289.html |  | WS2812D | WS2812D |  |  |  | Programmable RGB LED |  |  |  |  |  | Aliexpress |  | ￡4.12
 | U17 | [/] |  |  | EP4CE6E22C8N_FPGA_Development_Board | EP4CE6E22C8N_FPGA_Development_Board |  |  |  | EP4CE6E22C8N_FPGA_Development_Board |  |  |  |  |  | Aliexpress
 | U18 | [/] | https://www.mouser.co.uk/ProductDetail/Texas-Instruments/LM4040A20IDBZR?qs=VBduBm9rCJS7ix0kTeCDJA%3D%3D |  | LM4040A20IDBZR | LM4040A20IDBZR |  |  |  | LM4040A20IDBZR 2.048v reference |  | 0.l% | 2.048v |  |  | Mouser | 595-LM4040A20IDBZR | £1.42
 | U19 | [/] | https://www.aliexpress.com/item/1005010771301622.html?curPageLogUid=bhGa5rS273EV |  | LM2956HVT-ADJ | LM2956HVT-ADJ |  |  |  | LM2956HVT-ADJ adjustable regulator |  |  |  |  |  | Aliexpress
 | U20 |  | https://www.mouser.co.uk/ProductDetail/Analog-Devices/AD7822BNZ?qs=%2FtpEQrCGXCyXv71BkCSjyQ%3D%3D |  | AD7822BNZ | AD7822BNZ |  |  |  | AD7822BNZ |  |  |  |  |  | Mouser | 584-AD7822BNZ | £16.75
 | U21 | [/] | https://www.mouser.co.uk/ProductDetail/IXYS/IXFP60N25X3?qs=5aG0NVq1C4yTnBULxG9HTw%3D%3D | ‎ | MOSFETs 250V/60A Ultra Junct ion X3-Class MOSFET | IXFP60N25X3 |  | 1 |  | MOSFETs 250V/60A Ultra Junct ion X3-Class MOSFET |  |  |  |  |  | Mouser | 747-IXFP60N25X3 | £6.86 | £6.86
 | U22 | [/] | https://www.mouser.co.uk/ProductDetail/IXYS/IXFP60N25X3?qs=5aG0NVq1C4yTnBULxG9HTw%3D%3D | ‎ | MOSFETs 250V/60A Ultra Junct ion X3-Class MOSFET | IXFP60N25X3 |  | 1 |  | MOSFETs 250V/60A Ultra Junct ion X3-Class MOSFET |  |  |  |  |  | Mouser | 747-IXFP60N25X3 | £6.86 | £6.86
 | U23 | [/] | https://www.mouser.co.uk/ProductDetail/Infineon-Technologies/IR2010PBF?qs=2r01AXMCG3OJtVSU%2F%252BPmvA%3D%3D |  | IR2010PBF | IR2010PBF |  |  |  | IR2010PBF high low gate driver |  |  |  |  |  | Mouser | 942-IR2010PBF
 | U24 | [/] | https://www.mouser.co.uk/ProductDetail/Infineon-Technologies/IR2010PBF?qs=2r01AXMCG3OJtVSU%2F%252BPmvA%3D%3D |  | IR2010PBF | IR2010PBF |  |  |  | IR2010PBF high low gate driver |  |  |  |  |  | Mouser | 942-IR2010PBF
 | U25 | [?] |  |  | 2N7000 | 2N7000 |  |  |  | 2N7000 |  |  |  |  |  | Aliexpress
 | U26 | [/] | https://www.mouser.co.uk/ProductDetail/IXYS/IXFP60N25X3?qs=5aG0NVq1C4yTnBULxG9HTw%3D%3D | ‎ | MOSFETs 250V/60A Ultra Junct ion X3-Class MOSFET | IXFP60N25X3 |  | 1 |  | MOSFETs 250V/60A Ultra Junct ion X3-Class MOSFET |  |  |  |  |  | Mouser | 747-IXFP60N25X3 | £6.86 | £6.86
 | U27 | [/] | https://www.mouser.co.uk/ProductDetail/IXYS/IXFP60N25X3?qs=5aG0NVq1C4yTnBULxG9HTw%3D%3D | ‎ | MOSFETs 250V/60A Ultra Junct ion X3-Class MOSFET | IXFP60N25X3 |  | 1 |  | MOSFETs 250V/60A Ultra Junct ion X3-Class MOSFET |  |  |  |  |  | Mouser | 747-IXFP60N25X3 | £6.86 | £6.86
 | U28 |  | https://www.aliexpress.com/item/1005006982300493.html |  | LM2596 LM2596HVS power supply module DC-DC BUCK 3A | LM2596 LM2596HVS power supply module DC-DC BUCK 3A |  |  |  |  |  |  |  |  |  | Aliexpress |  | £1.21
 | U29 |  | https://www.aliexpress.com/item/1005006982300493.html |  | LM2596 LM2596HVS power supply module DC-DC BUCK 3A | LM2596 LM2596HVS power supply module DC-DC BUCK 3A |  |  |  |  |  |  |  |  |  | Aliexpress |  | £1.21
 | U30 |  | https://www.aliexpress.com/item/1005006982300493.html |  | LM2596 LM2596HVS power supply module DC-DC BUCK 3A | LM2596 LM2596HVS power supply module DC-DC BUCK 3A |  |  |  |  |  |  |  |  |  | Aliexpress |  | £1.21
 | U31 |  | https://www.aliexpress.com/item/1005006982300493.html |  | LM2596 LM2596HVS power supply module DC-DC BUCK 3A | LM2596 LM2596HVS power supply module DC-DC BUCK 3A |  |  |  |  |  |  |  |  |  | Aliexpress |  | £1.21

Sheet: High Voltage Feedback
Subsystem | Item # | Url | ‎ | Part Name | Part Number | Category | Quantity Needed | Quantity in Stock | Description | Value/Rating | Tolerance | Voltage Rating | Power Rating | Package/Size | Supplier | Supplier Part Number | Unit Price | Total Cost | Lead Time | Notes
Voltage Feedback Board |  | ‎ | ‎ | Zener diode over voltage clamp | 1N4619 BK PBFREE |  | 1 | 0 | zener diode protection, 3v 0.8uA leakage | ‎ | 5% | 3 | 0.25w | DO-35-2
 |  | https://www.mouser.co.uk/ProductDetail/Murata-Power-Solutions/MHR0844SA107F70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 | ‎ | Potential divider upper leg resistors | MHR0844SA107F70 (https://www.mouser.co.uk/ProductDetail/Ohmite/SM108033006FE) |  | 2 | 0 | Thick Film Resistors - Through Hole 300M ohms 1% | 100M | 1% | 15.8 kV | 2.5w |  |  |  | £2.56 | £5.12
 |  | https://www.mouser.co.uk/ProductDetail/YAGEO/MFR-25FRF52-27K?qs=sGAEpiMZZMsPqMdJzcrNwiweiCzxKzWLhyrsT9Ty9ww%3D | ‎ | Potential divider lower leg resistor | MFR-25FRF52-27K (https://www.mouser.co.uk/ProductDetail/YAGEO/MFR-25FBF52-45K3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) |  | 1 | 0 | Metal Film Resistors - Through Hole 27K OHM 1/4W 1% | 27000 | 1% | 300v | 0.25w
 |  | ‎ | ‎ | Potential divider lower bias capacitor | C322C271K2G5TA |  | 1 | 0 | Multilayer Ceramic Capacitors MLCC - Leaded 50V 1000pF C0G 1% LS=5.08mm | 270pf | 1% | 250v
 |  | ‎ | ‎ | Fiber optic transmitter | RS Stock No.:270-7764 |  | 2 | 0 | RS PRO 16Mbps Fibre Optic Transmitter 640 → 670nm, Square Fiber Optic Connector, 13.6 x 11.5 x 9.5mm SUPPORTS toslink | ‎
 |  | ‎ | ‎ | Fiber optic receiver | RS Stock No.:270-7763 |  | 1 | 0 | RS PRO 16Mbps 650nm Fibre Optic Receiver, Square, Fiber Optic Connector SUPPORTS toslink | ‎
 |  | ‎ | ‎ |  | C317C300J5G5TA (https://www.mouser.co.uk/ProductDetail/KEMET/C317C300J5G5TA?qs=b8KOIaRqXtdsFXPxXiN2GA%3D%3D) |  | 1 | 0 | Multilayer Ceramic Capacitors MLCC - Leaded 50V 30pF C0G 5% LS=5.08mm | 30pf | 5% | 50v
 |  | ‎ | ‎ |  | C322C104J5R5TA |  | 3 | 0 | Multilayer Ceramic Capacitors MLCC - Leaded 50V 0.1uF X7R 5% LS=5.08mm | 0.1uf | 5% | 50v
 |  | ‎ | ‎ | Male Male pin strip |  | ‎ |  |  |  | ‎
Villard First Stage Potential Divider |  | https://www.mouser.co.uk/ProductDetail/Murata-Power-Solutions/MHR0844SA107F70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 | ‎ | Potential divider upper leg resistors | MHR0844SA107F70 (https://www.mouser.co.uk/ProductDetail/Ohmite/SM108033006FE) |  | 2 | 0 | Thick Film Resistors - Through Hole 300M ohms 1% | 100M | 1% | 15.8 kV | 2.5w |  |  |  | £2.56 | £5.12
 |  | https://www.aliexpress.com/item/1005004279932436.html | ‎ | Potential divider upper leg resistors | HVR82MY5010 100MF 1% (https://www.mouser.co.uk/ProductDetail/Ohmite/SM108033006FE) |  | 2 | 0 | HVR82MY5010 100MF (1% version) | 100M | 1% | 15.8 kV | 3.5w |  | Alibaba: twjohm |  | £0.80 | £1.59
200KV Villard Output Voltage |  | https://www.aliexpress.com/item/1005004279932436.html | ‎ | Potential divider upper leg resistors | HVR82MY5010 1GF 1% |  | 14 | 0 | HVR82MY5010 1GF (1% version) | 1G ohm | 1% | 25kv | 3.5w |  | Alibaba: twjohm |  | £0.97 | £13.58
 |  | https://www.aliexpress.com/item/1005003776755496.html?mp=1 |  | Potential divider calculations |  |  |  |  | M2 standoffs kit
 |  |  |  |  | Instance name | First Stage Voltage Feedback | Output Voltage Feedback 200Kv
 |  |  |  |  | Safety factor | 1.2 | 1.2
 |  |  |  |  | Maximum zener diode leakage current | 8e-07 | 8e-07
 |  |  |  |  | Maximum high voltage | 20000 | 250000
 |  |  |  |  | Minimum high voltage | 1000 | 50000
 |  |  |  |  | Maximum tap voltage | 2.7 | 2.7
 |  |  |  |  | Minimum tap voltage
 |  |  |  |  | Resistor ratio required | 7407.407407 | 92592.59259
 |  |  |  |  | X zener leakage current minimum | 6 | 4
 |  |  |  |  | minimum current | 4.8e-06 | 3.2e-06
 |  |  |  |  | maximum RL to give high enough current | 4166666667 | 78125000000 |  | Composite resistor combination finding
 |  |  |  |  | Power dissipated at maximum series resistance and high voltage | 0.096 | 0.8 |  | max voltage | 200000 | 250000
 |  |  |  | High volatge resistor Rh | Rh minimum individual voltage rating required | 12000 | 23076.92308 |  | safety factor | 1.2 | 1.2
 |  |  |  |  | Rh individual high voltage resistor resistance | 100000000 | 1000000000 |  | resistance required | 13500000000 | 300000
 |  |  |  |  | Rh actual voltage rating | 15800 | 25000 |  | voltage rating of part | 25000 | 25000
 |  |  |  |  | Rh tolerance percent | 1 | 1 |  | n parts required minimum | 10 | 12
 |  |  |  |  | Rh power rating | 2.5 | 3.5 |  | actual number of parts using | 13 | 15
 |  |  |  |  | Resistor part | MHR0844SA107F70 | HVR82MY5010 1GF |  | desired resistance | 1038461538 | 20000
 |  |  |  | Low voltage resistor Rl | Suggested value | 27000 | 10800 |  | desired resistance M | 1038.461538 | 0.02
 |  |  |  |  | RL voltage rating | 300 |  |  | voltage across each part | 15384.61538 | 16666.66667
 |  |  |  |  | RL resistance | 27000 | 18200 |  | power dissipation in each part | 0.2279202279 | 13888.88889
 |  |  |  |  | RL tolerance percent | 1 | 1 |  | Url | https://www.aliexpress.com/item/1005004279932436.html | https://www.aliexpress.com/item/1005004279932436.html
 |  |  |  |  | Rl power rating | 0.25 | 0.25 |  | part number | HVR82MY5010 1GF (1% version) | HVR82MY5010 1GF (1% version)
 |  |  |  |  | Resistor part | RN60C1351FB14 |  |  | voltage rating | 25000 | 25000
 |  |  |  |  | Rh individual maximum resistance | 101000000 | 1010000000 |  | tolerance | 1% | 1%
 |  |  |  |  | Rh individual minimum resistance | 99000000 | 990000000 |  | resistance | 1G | 200K
 |  |  |  |  | Nrh high voltage resistors | 2 | 13 |  | unit price | £0.97
 |  |  |  |  | RH tolerance proportion | 0.01 | 0.01 |  | total price | £12.61
 |  |  |  |  | RH total series resistance | 200000000 | 13000000000 |  | part power rating | 3.5W | 3.5W
 |  |  |  |  | RH maximum resistance | 202000000 | 13130000000 |  | unit length mm | 50 | 51
 |  |  |  |  | RH minimum resistance | 198000000 | 12870000000
 |  |  |  |  | Nrh x Vrh Total voltage rating | 31600 | 325000
 |  |  |  |  | Nrh x Vrh / safety factor Operating voltage rating | 26333.33333 | 270833.3333
 |  |  |  |  | RH tolerance proportion | 0.01 | 0.01
 |  |  |  |  | RL maximum resistance | 27270 | 18382
 |  |  |  |  | RL minimum resistance | 26730 | 18018
 |  |  |  |  | High voltage resistors Acceptible voltage rating | TRUE | TRUE
 |  |  |  |  | Low voltage resistor acceptible voltage rating
 |  |  |  |  | Minimum current (at lowest high voltage and highest end of tolerance) | 4.949833438e-06 | 3.808067836e-06
 |  |  |  |  | Maximum current (at highest high voltage and lowest end of tolerance) | 0.0001009964665 | 1.942499223e-05
 |  |  |  |  | Acceptibly large current at minimum high voltage | TRUE | TRUE
 |  |  |  |  | Alter resistance by proportion |  | 1.190022848
 |  |  |  |  | P_Rh Maximum power disipation individual high voltage resistor | 1.030228911 | 0.3811036264
 |  |  |  |  | P_RL Maximum power disipation low voltage resistor | 0.0002781618058 | 6.936086e-06
 |  |  |  |  | Rh maximum power rating including safety factor | 2.083333333 | 2.916666667
 |  |  |  |  | Rl maximum power rating including safety factor | 0.2083333333 | 0.2083333333
 |  |  |  |  | Rh power rating acceptible | TRUE | TRUE
 |  |  |  |  | Rl power rating acceptible | TRUE | TRUE
 |  |  |  |  | Total power loss | 2.060735983 | 4.954354079
 |  |  |  |  | Minimum cycles to rise through full voltage range (limited by energy transformer can transfer to capacitor per cycle) | 6 | 6
 |  |  |  |  | Minimum cycles to fall through full voltage range (limited by output current limiting resistance) | 1 | 1
 |  |  |  |  | Minimum transition time | 1 | 1
 |  |  |  |  | Frequency of driver | 16000 | 16001
 |  |  |  |  | Period | 6.25e-05 | 6.249609399e-05
 |  |  |  |  | t_99% desired | 3.125e-05 | 3.1248047e-05
 |  |  |  |  | Effective time constant τ desired | 6.786102063e-06 | 6.785677958e-06
 |  |  |  |  | Suggested lower leg capacitance | 2.513371134e-10 | 3.728394483e-10
 |  |  |  | Lower leg capacitor | Actual lower leg capacitance | 2.7e-10 | 3.7e-10
 |  |  |  |  | t_99% actual | 3.356596346e-05 | 3.101002702e-05
 |  |  |  |  | Effective time constant τ for actual capacitor | 7.289025724e-06 | 6.733990666e-06
 |  |  |  |  | V_∞min | 0.1349817775 | 0.069999902
 |  |  |  |  | V_∞max | 2.7 | 2.7
 |  |  |  |  | Time taken for V_L to go from maximum to within 0.99 of minimum value | 5.503033115e-05 | 5.543027519e-05
 |  |  |  |  | N Cycles taken for V_L to go from maximum to within 0.99 of minimum value | 0.8804852984 | 0.8869398332
 |  |  |  |  | Time taken for V_L to go from lowest to within 0.99 of maximum value | 3.319337759e-05 | 3.083428532e-05
 |  |  |  |  | N cycles taken for V_L to go from lowest to within 0.99 of maximum value | 0.5310940415 | 0.4933793995
 |  |  |  |  | Suitable | TRUE | TRUE
 |  |  | ‎
 |  |  | ‎
 |  |  | ‎
 |  |  | ‎
 |  |  | ‎
 |  |  | ‎
 |  |  | ‎
 |  |  | ‎
 |  |  | ‎
 |  |  | ‎
 |  |  | ‎
 |  |  | ‎
 |  |  | ‎
 |  |  | ‎
 |  |  | ‎
 |  |  | ‎
 |  |  | ‎
 |  |  | ‎
 |  |  | ‎
 |  |  | ‎
 |  |  | ‎
 |  |  | ‎
 |  |  | ‎

Sheet: VillardVessel
https://www.trentplastics.co.uk/product/clear-acrylic-tube/ |  |  |  | 200x5x190x1000 | 64
 |  |  |  | 3mm | £39.00
 | OD tube
 | ID tube | 0.17 | m
 | Height tube | 1 | m
 | Mineral oil volume | 0.02269800692 | m^3
 | Density | 870 | kg/m^3
 | Mass of mineral oil | 19.74726602
 | Safety factor | 4
 | Bending moment about base when on side filled supported at base | 96.86033984
 | Minimum distance between vessel base bolts | 0.154
 | Maximum bending moment on bolt | 628.9632457
 | Required bolt tensile strength | 2515.852983 | N
 | σ_nylon | 70000000
 | Required bolt tensile stress area | 3.59407569e-05 | m^2
 | Required Tensile stress diameter | 0.006764701985

Sheet: Sheet2
https://www.aliexpress.com/item/1005006754784195.html?mp=1
https://www.aliexpress.com/item/1005007549969044.html?mp=1

Sheet: Sheet5
Screw Terminals
https://eu.mouser.com/ProductDetail/TE-Connectivity/9-55556-0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 | 9-55556-0
 | 214786-E
https://www.mouser.co.uk/ProductDetail/TE-Connectivity/1-55323-0?qs=ZDXmSm13593kmHLkU9RFpw%3D%3D | 1-55323-0
https://www.mouser.co.uk/ProductDetail/TE-Connectivity/5055323-5?qs=Y2IUIqUeZibHL7okQXpZvA%3D%3D | 5055323-5
https://www.aliexpress.com/item/1005008932232226.html?curPageLogUid=41CHMsdYaM7F | M4 PCB Screw Terminal 6 Pin in PCB Welding Terminal P/N 7798
https://www.aliexpress.com/item/1005009170628482.html?scm_id=1007.40050.354490.0&scm-url=1007.40050.354490.0 | 5PCS PCB 5 Solder Terminals / M6 high current terminal 120A Circuit Board Hardware PCB-5 M6 Connector
