MrWobot/hvps/Code/JavaScript/client/src/components/spinners/spinner1.gif

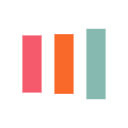
Code/JavaScript/client/src/components/spinners/spinner1.gif
