MrWobot/hvps/Structure/FlybackBobin/FindSmallestThickness_FullBobin.stl

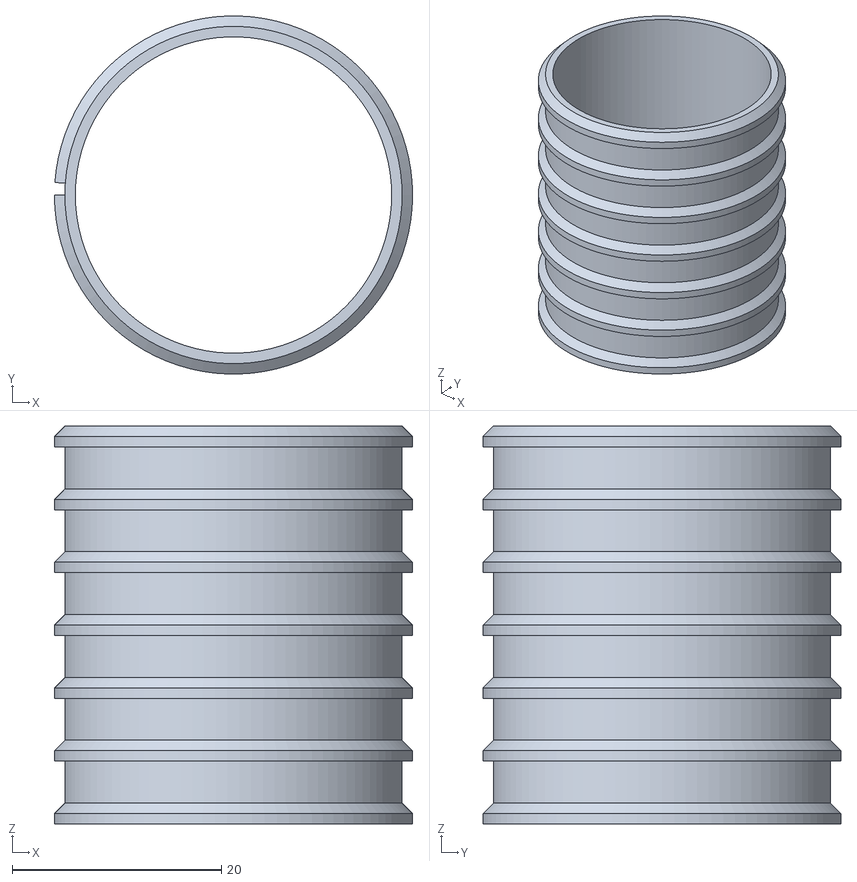
[picture p11: CAD file, 2026-07-01]
Structure/FlybackBobin/FindSmallestThickness_FullBobin.stl
34.2 x 34.2 x 38.0
