MrWobot/hvps/Structure/Assembly/U.3mf

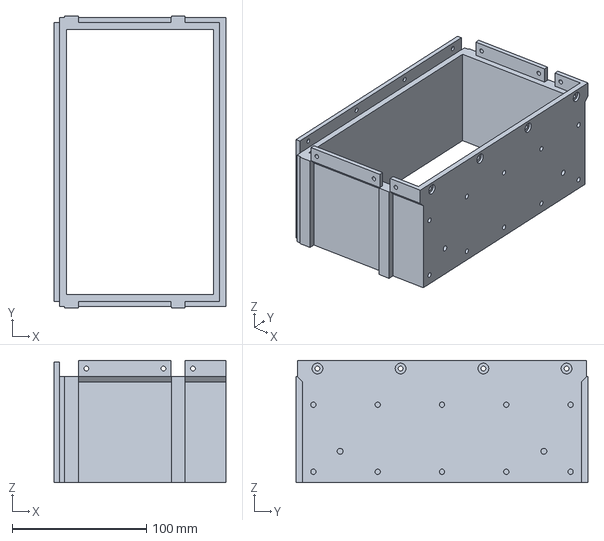
[picture p13: CAD file, 2026-07-01]
Structure/Assembly/U.3mf
128.0 x 217.8 x 91.0 mm
