MrWobot/hvps/Structure/DummyLoadResistorsCase2/DummyLoadResistorsCase2.3mf

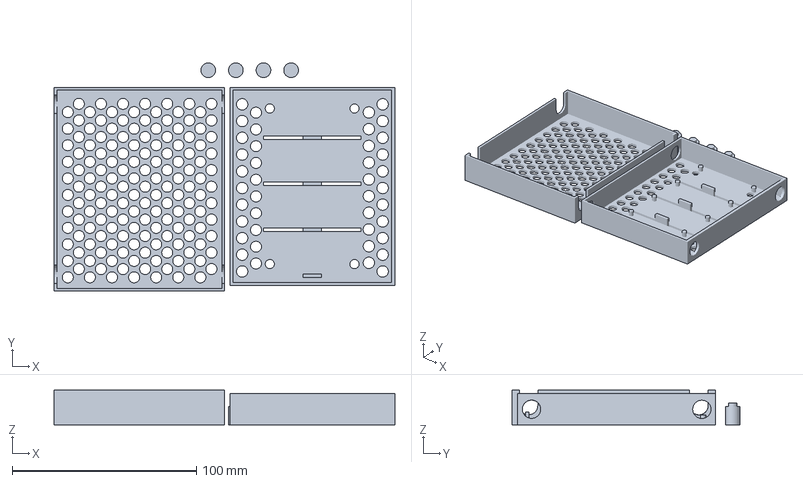
[picture p14: CAD file, 2026-06-12]
Structure/DummyLoadResistorsCase2/DummyLoadResistorsCase2.3mf
185.2 x 124.0 x 19.0 mm
