MrWobot/hvps/Structure/FlybackBobin/FindSmallestThickness_Spacer.stl

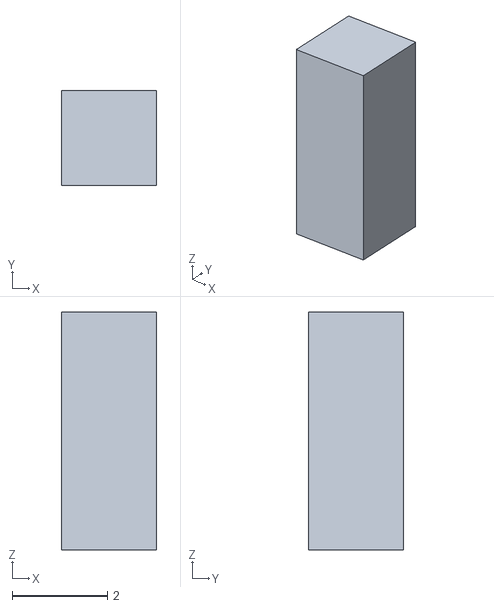
[picture p15: CAD file, 2026-07-01]
Structure/FlybackBobin/FindSmallestThickness_Spacer.stl
2.00 x 2.00 x 5.00
