MrWobot/hvps/Code/C#/FlybackModelling/Meshes/UsingPC40_UU120X160X20.obj

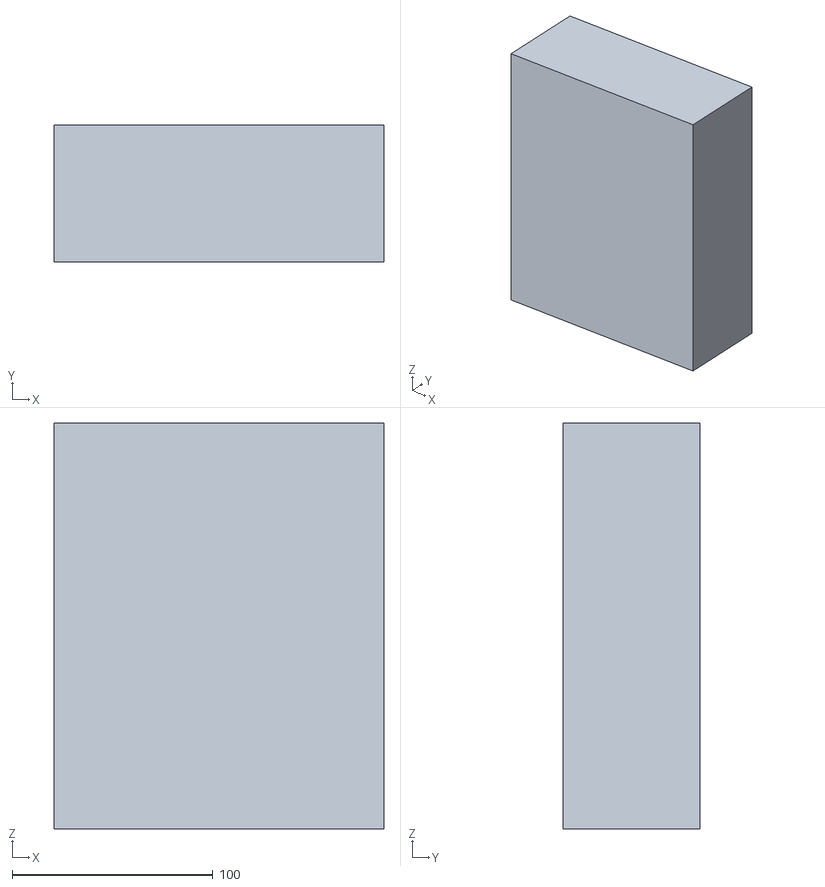
[picture p16: CAD file, 2026-06-12]
Code/C#/FlybackModelling/Meshes/UsingPC40_UU120X160X20.obj
164.0 x 68.0 x 202.0
Mesh1 Model
Mesh2 Model
Mesh3 Model
Mesh4 Model
Mesh5 Model
Mesh6 Model
Mesh7 Model
Mesh8 Model
Mesh9 Model
Mesh10 Model
Mesh11 Model
Mesh12 Model
Mesh13 Model
Mesh14 Model
Mesh15 Model
Mesh16 Model
Mesh17 Model
Mesh18 Model
Mesh19 Model
Mesh20 Model
Mesh21 Model
Mesh22 Model
Mesh23 Model
Mesh24 Model
