MrWobot/hvps/Structure/Assembly/W.3mf

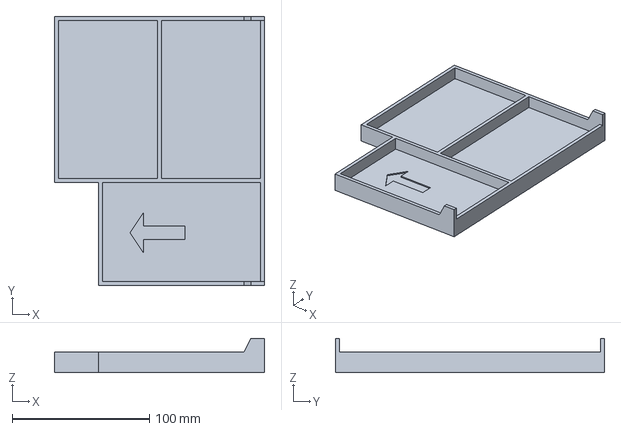
[picture p17: CAD file, 2026-07-01]
Structure/Assembly/W.3mf
153.0 x 196.0 x 25.0 mm
