MrWobot/hvps/Structure/FlybackBobin/FindSmallestThickness_ring.stl

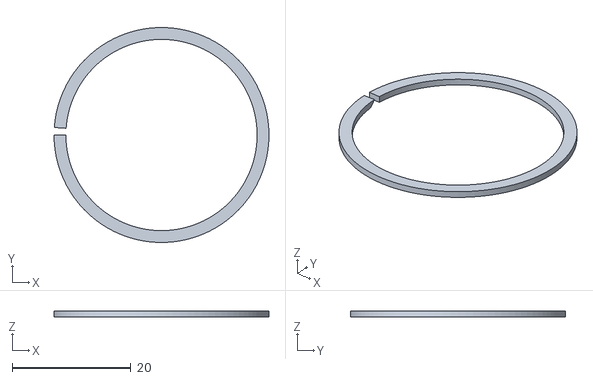
[picture p18: CAD file, 2026-07-01]
Structure/FlybackBobin/FindSmallestThickness_ring.stl
36.2 x 36.2 x 1.00
