MrWobot/hvps/Code/C#/FlybackModelling/Meshes/FlybackTransformer.obj

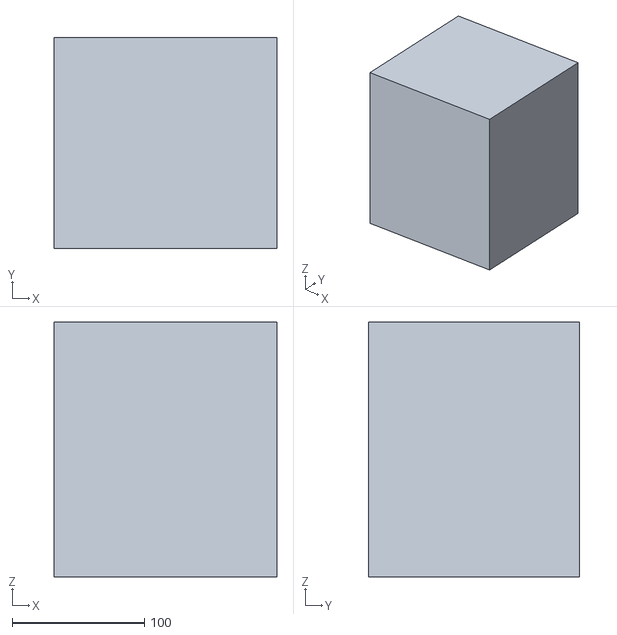
[picture p19: CAD file, 2026-06-12]
Code/C#/FlybackModelling/Meshes/FlybackTransformer.obj
168.5 x 159.5 x 193.0
