MrWobot/hvps/Structure/Assembly/4kVVillardsCaseLid.3mf

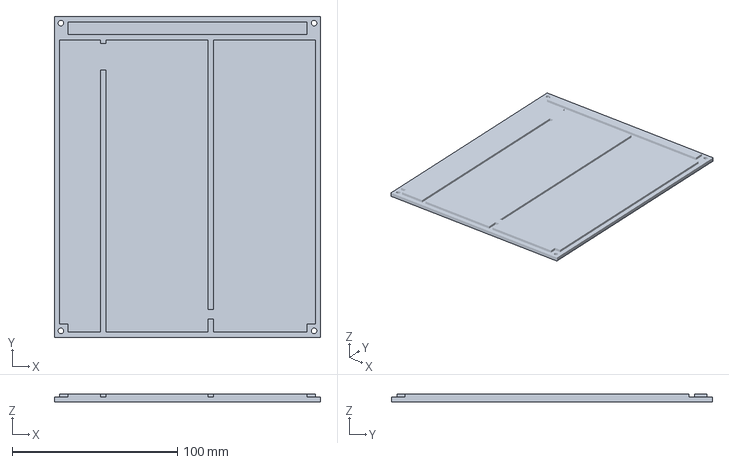
[picture p20: CAD file, 2026-07-01]
Structure/Assembly/4kVVillardsCaseLid.3mf
161.0 x 194.0 x 5.00 mm
