MrWobot/hvps/Structure/FlybackBobin/FindSmallestThickness.3mf

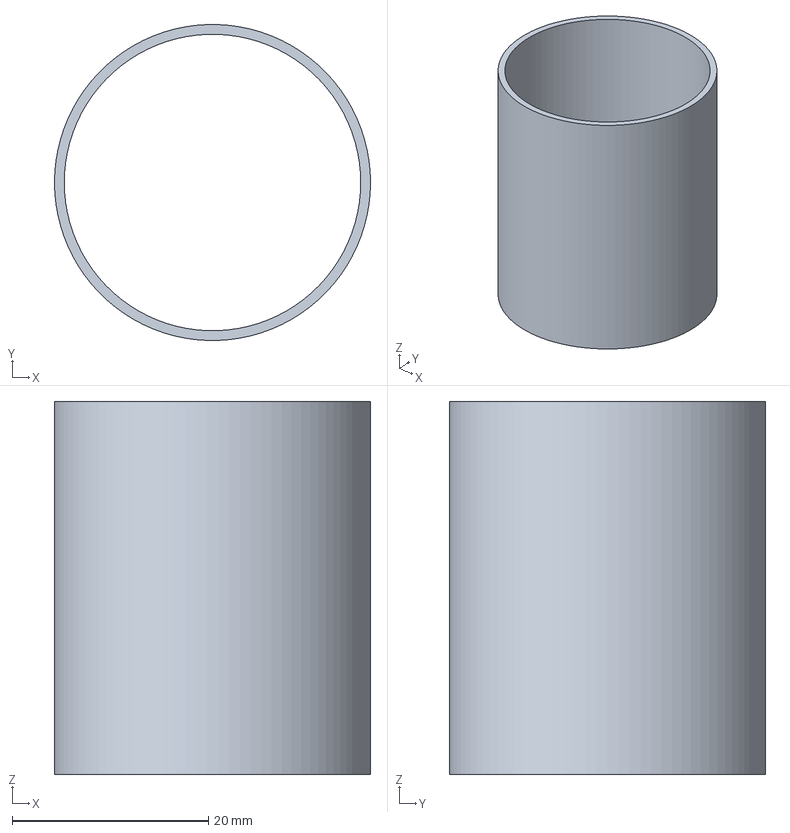
[picture p21: CAD file, 2026-07-01]
Structure/FlybackBobin/FindSmallestThickness.3mf
32.2 x 32.2 x 38.0 mm
