MrWobot/hvps/Code/C#/FlybackModelling/Meshes/CheckingCurrentDensity.obj

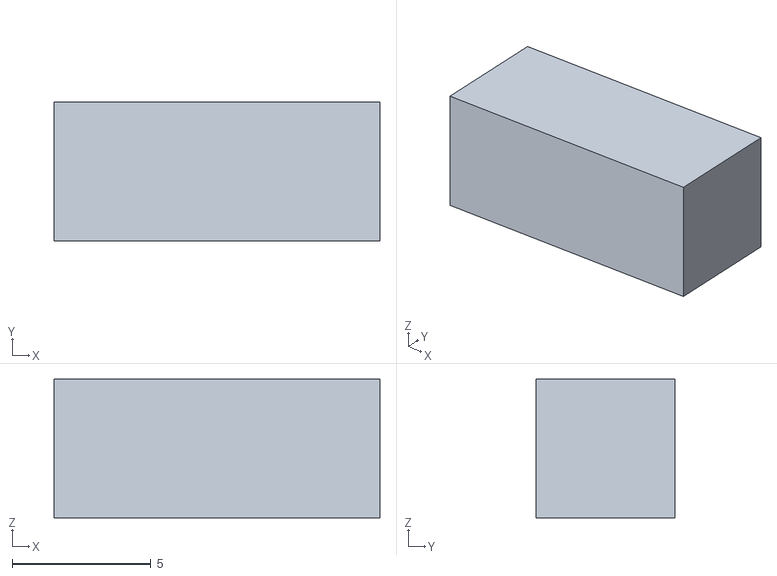
[picture p22: CAD file, 2026-06-12]
Code/C#/FlybackModelling/Meshes/CheckingCurrentDensity.obj
11.8 x 5.00 x 5.00
Mesh1 Component_1_1 Model
Mesh2 Component_1_1 Model
