MrWobot/hvps/Structure/Assembly/V.3mf

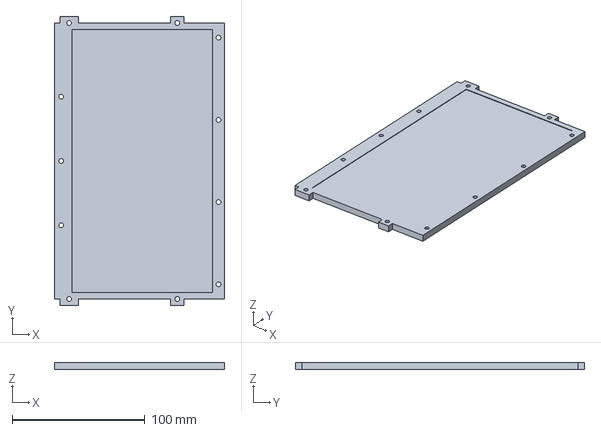
[picture p23: CAD file, 2026-07-01]
Structure/Assembly/V.3mf
128.0 x 217.8 x 5.40 mm
