MrWobot/hvps/Structure/Assembly/4kVBobin.3mf

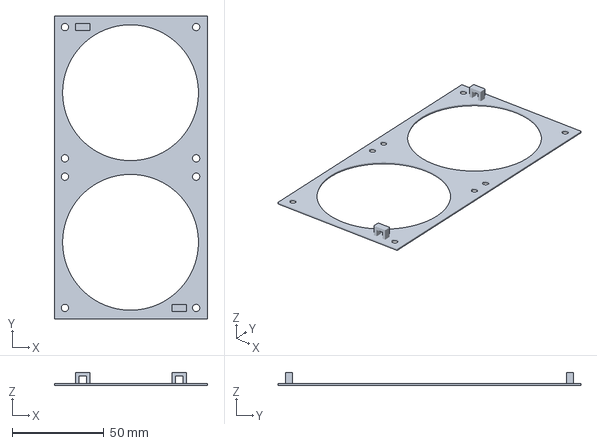
[picture p24: CAD file, 2026-07-01]
Structure/Assembly/4kVBobin.3mf
83.6 x 165.1 x 7.00 mm
