MrWobot/hvps/Structure/Assembly/4kVVillardsCase.3mf

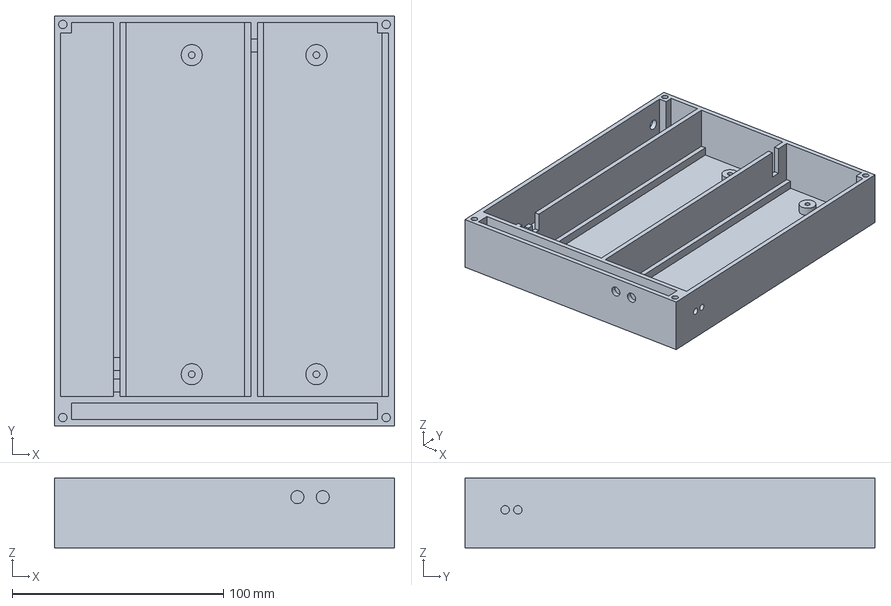
[picture p25: CAD file, 2026-07-01]
Structure/Assembly/4kVVillardsCase.3mf
161.0 x 194.0 x 33.0 mm
