MrWobot/hvps/Structure/FlybackBobin/FindSmallestThickness_1mm_with_slope_spacer.stl

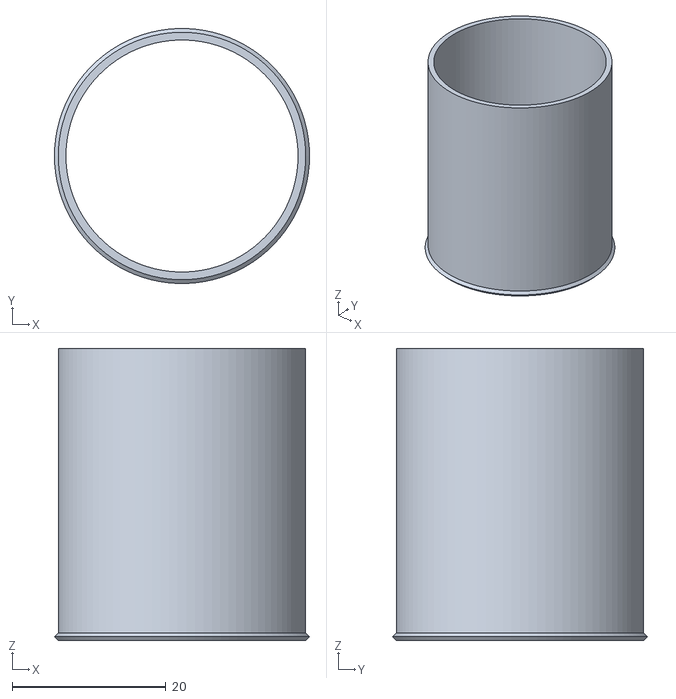
[picture p26: CAD file, 2026-07-01]
Structure/FlybackBobin/FindSmallestThickness_1mm_with_slope_spacer.stl
33.2 x 33.2 x 38.0
