MrWobot/hvps/Structure/Assembly/M.3mf

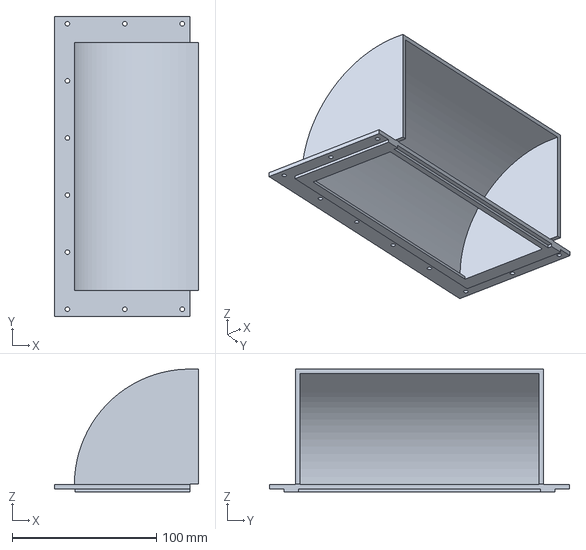
[picture p27: CAD file, 2026-06-12]
Structure/Assembly/M.3mf
99.8 x 207.8 x 85.0 mm
