MrWobot/hvps/Structure/FlybackBobin/FlybackBobinPerfectedSimpleDesign.stl

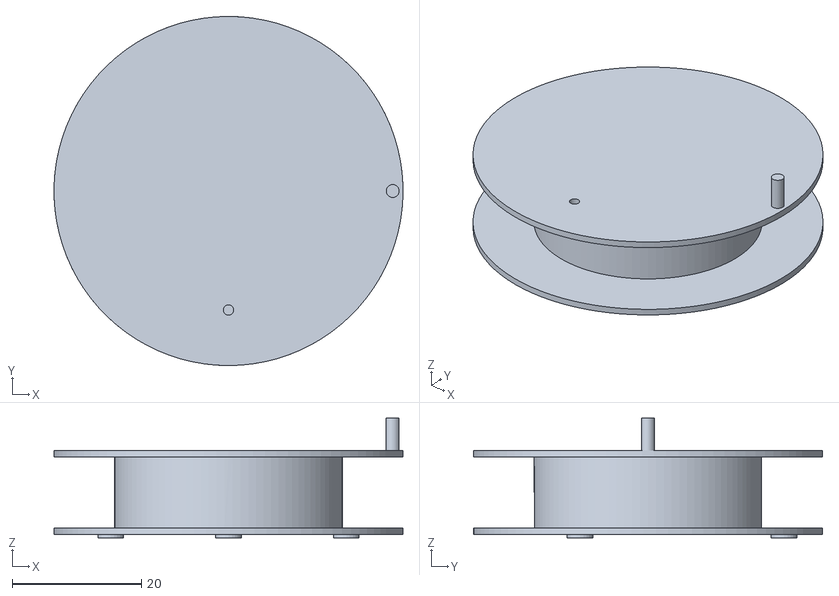
[picture p28: CAD file, 2026-06-12]
Structure/FlybackBobin/FlybackBobinPerfectedSimpleDesign.stl
54.0 x 54.0 x 18.5
