MrWobot/hvps/Structure/Assembly/TransformerCoreCap.3mf

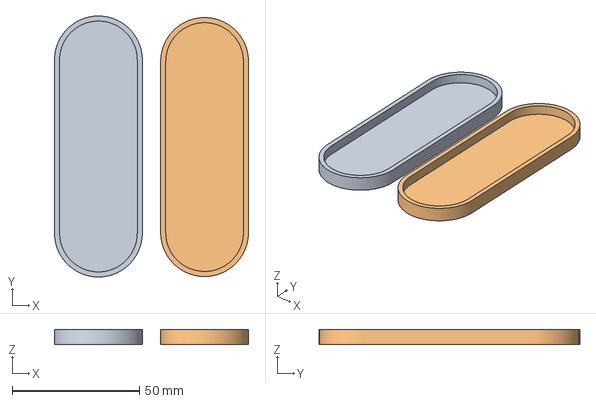
[picture p29: CAD file, 2026-06-12]
Structure/Assembly/TransformerCoreCap.3mf
76.2 x 102.5 x 6.00 mm
TransformerCoreCap.stl x 2
