MrWobot/hvps/Structure/FlybackBobin/FlybackBobin4LowestVoltageEnd.stl

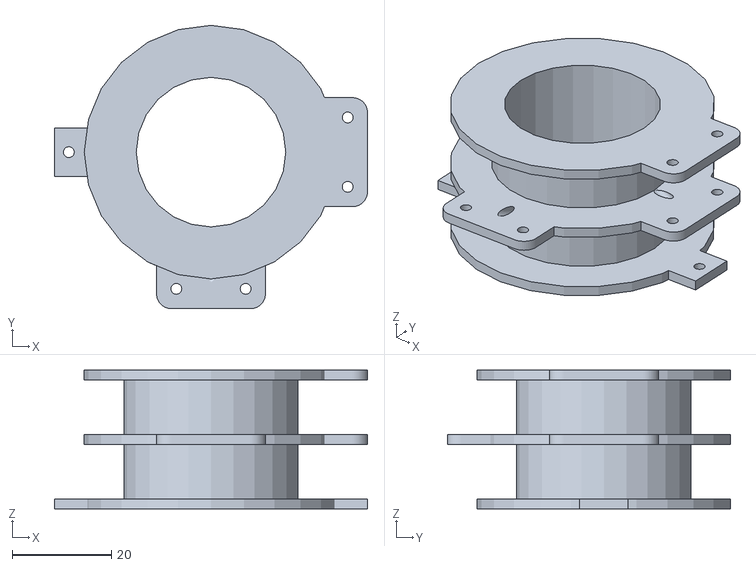
[picture p30: CAD file, 2026-06-12]
Structure/FlybackBobin/FlybackBobin4LowestVoltageEnd.stl
63.2 x 57.2 x 28.0
