MrWobot/hvps/Structure/Assembly/H.3mf

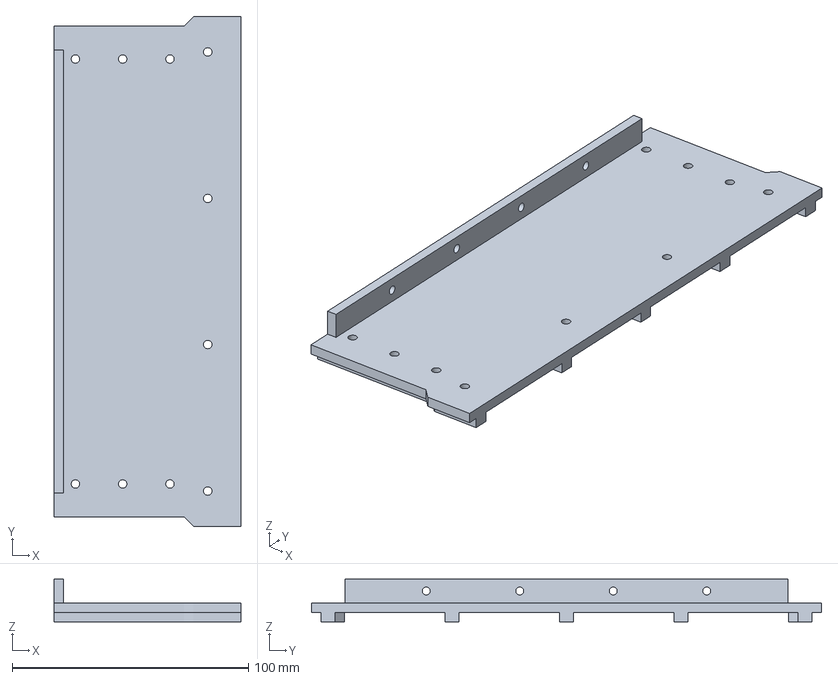
[picture p31: CAD file, 2026-06-12]
Structure/Assembly/H.3mf
79.0 x 215.8 x 18.0 mm
