MrWobot/hvps/Structure/FlybackBobin/FlybackBobin1HighestVoltageEnd.stl

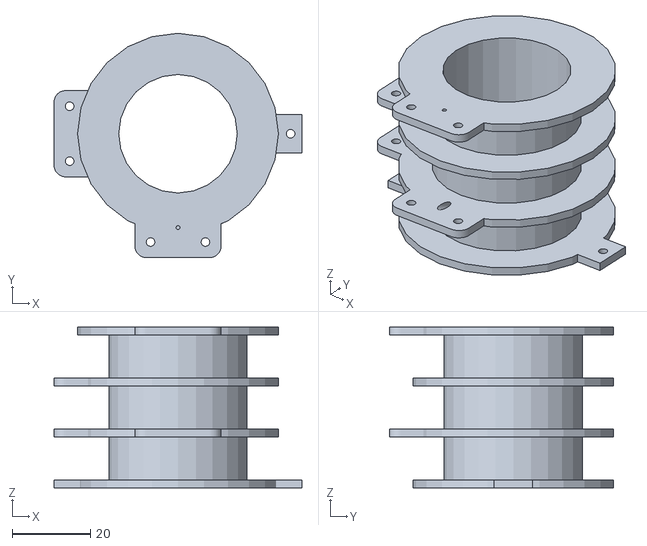
[picture p32: CAD file, 2026-06-12]
Structure/FlybackBobin/FlybackBobin1HighestVoltageEnd.stl
63.2 x 57.2 x 41.0
