MrWobot/hvps/Structure/Assembly/B.3mf

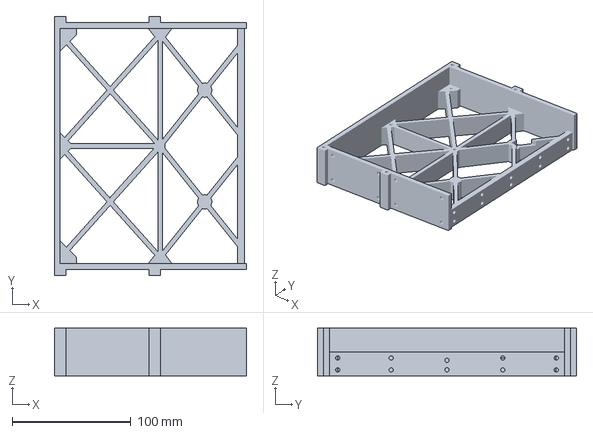
[picture p33: CAD file, 2026-06-12]
Structure/Assembly/B.3mf
161.8 x 217.8 x 40.0 mm
