MrWobot/hvps/Structure/FlybackBobin/WindingBoss.3mf

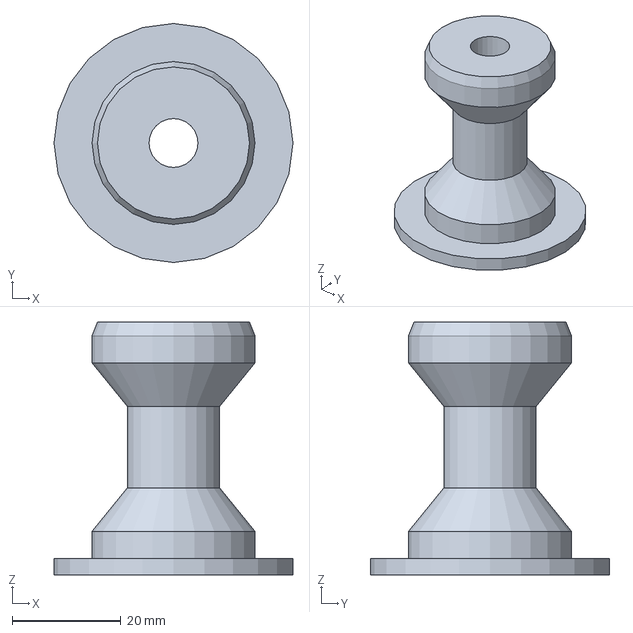
[picture p34: CAD file, 2026-06-12]
Structure/FlybackBobin/WindingBoss.3mf
44.0 x 44.0 x 46.5 mm
