MrWobot/hvps/Structure/Assembly/4KVVillardSolderingSpacers2.stl

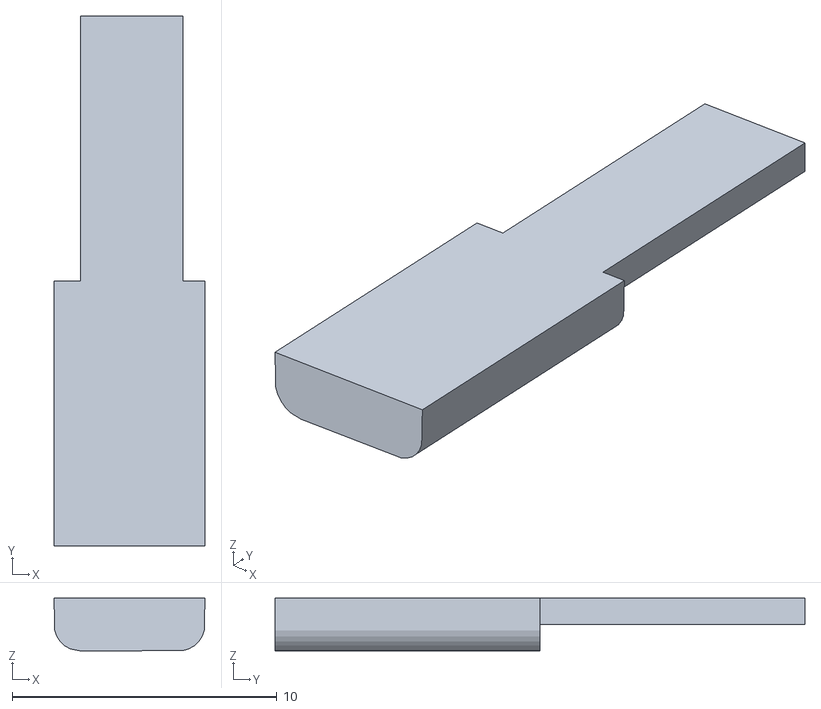
[picture p35: CAD file, 2026-06-12]
Structure/Assembly/4KVVillardSolderingSpacers2.stl
5.70 x 20.0 x 2.00
