MrWobot/hvps/Structure/FlybackBobin/CustomFlybackBobin.3mf

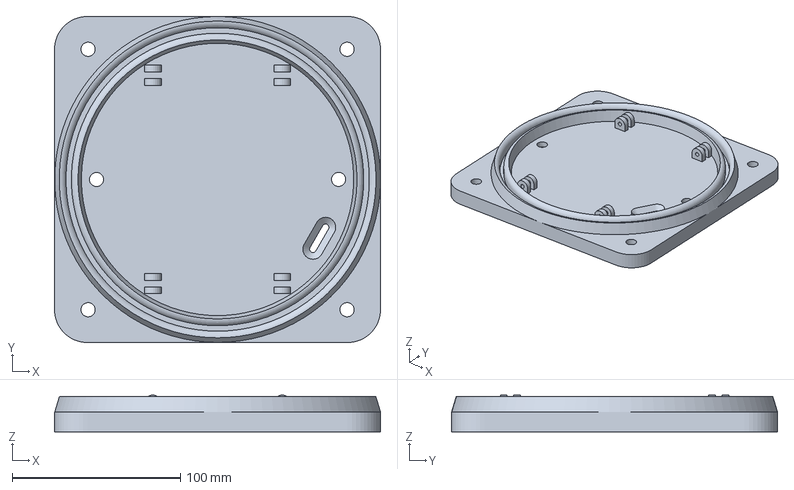
[picture p36: CAD file, 2026-06-12]
Structure/FlybackBobin/CustomFlybackBobin.3mf
194.0 x 194.0 x 22.0 mm
