MrWobot/hvps/Structure/Assembly/G.3mf

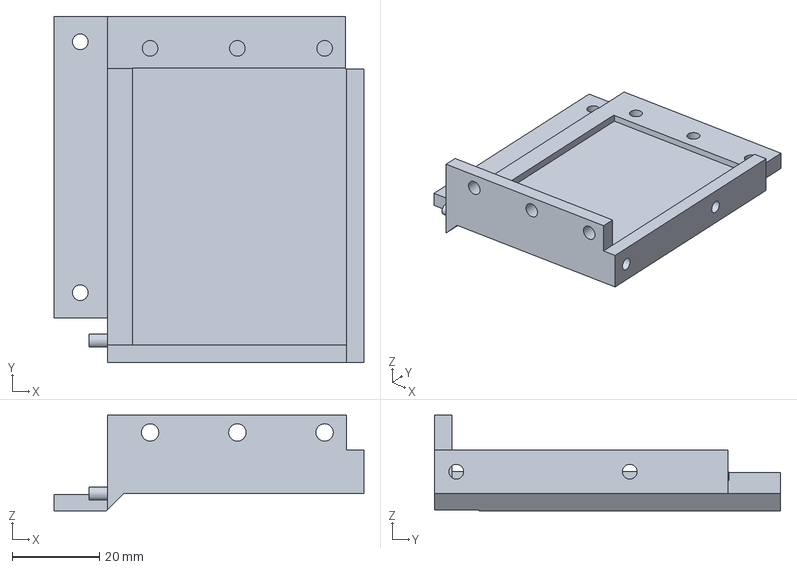
[picture p37: CAD file, 2026-06-12]
Structure/Assembly/G.3mf
71.0 x 79.3 x 22.0 mm
