MrWobot/hvps/Structure/Assembly/WireTidy.3mf

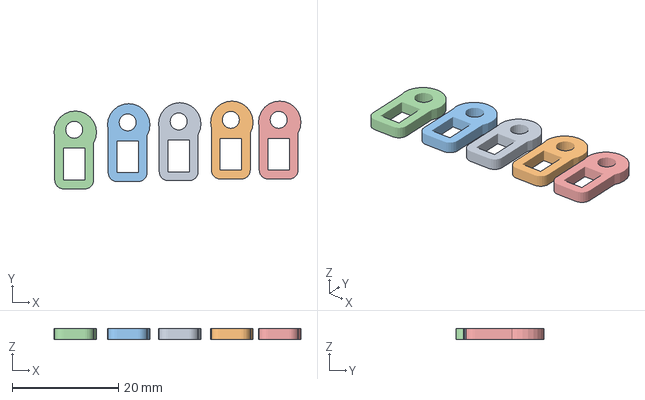
[picture p38: CAD file, 2026-06-12]
Structure/Assembly/WireTidy.3mf
46.5 x 16.5 x 2.00 mm
WireTidy.stl x 5
