MrWobot/hvps/Structure/Assembly/T.3mf

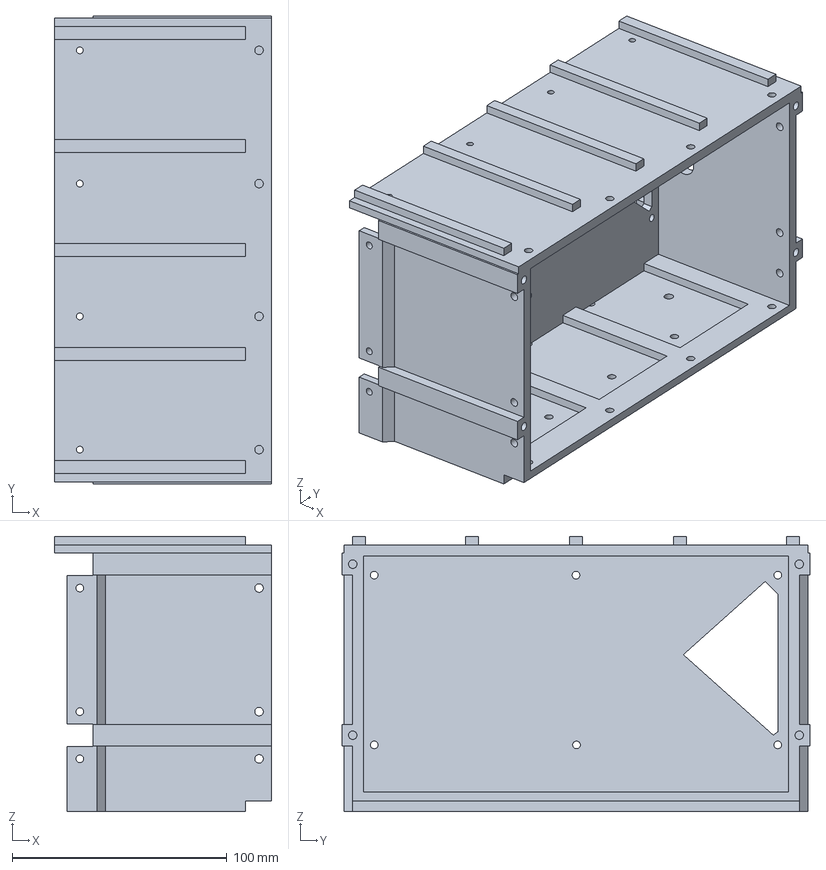
[picture p39: CAD file, 2026-06-12]
Structure/Assembly/T.3mf
101.0 x 217.8 x 128.0 mm
