MrWobot/hvps/Structure/Assembly/Q.3mf

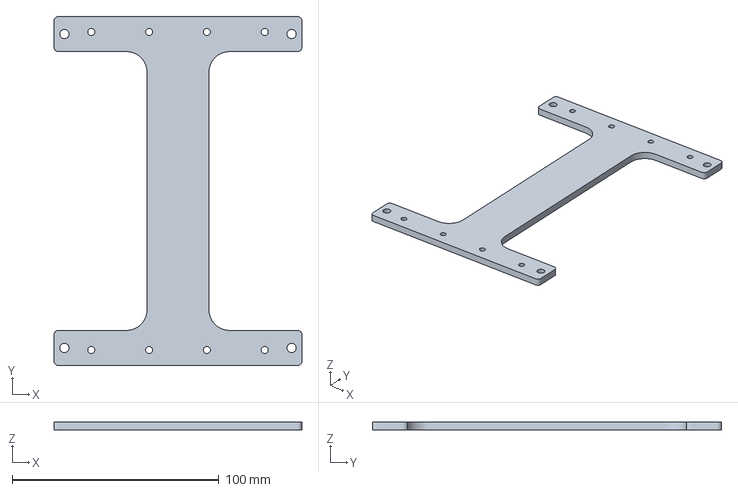
[picture p40: CAD file, 2026-06-12]
Structure/Assembly/Q.3mf
120.0 x 169.0 x 4.00 mm
