MrWobot/hvps/Structure/Assembly/A.3mf

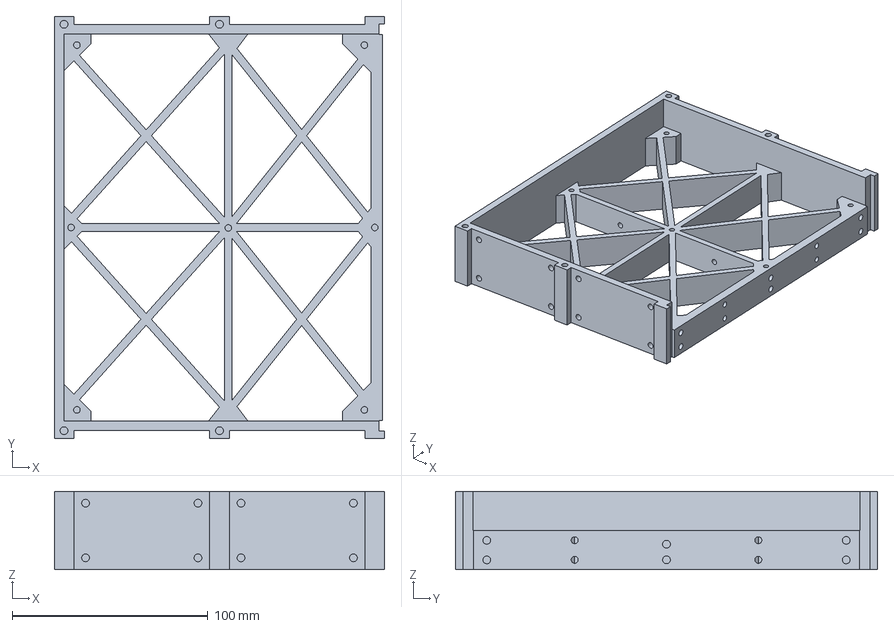
[picture p41: CAD file, 2026-06-12]
Structure/Assembly/A.3mf
169.0 x 215.8 x 40.0 mm
