MrWobot/hvps/Structure/FlybackBobin/TubePlate.3mf

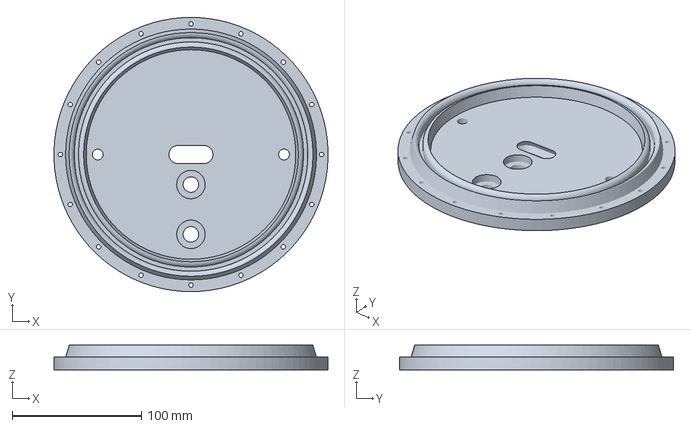
[picture p42: CAD file, 2026-06-12]
Structure/FlybackBobin/TubePlate.3mf
211.9 x 212.0 x 19.0 mm
