MrWobot/hvps/Structure/Assembly/P.3mf

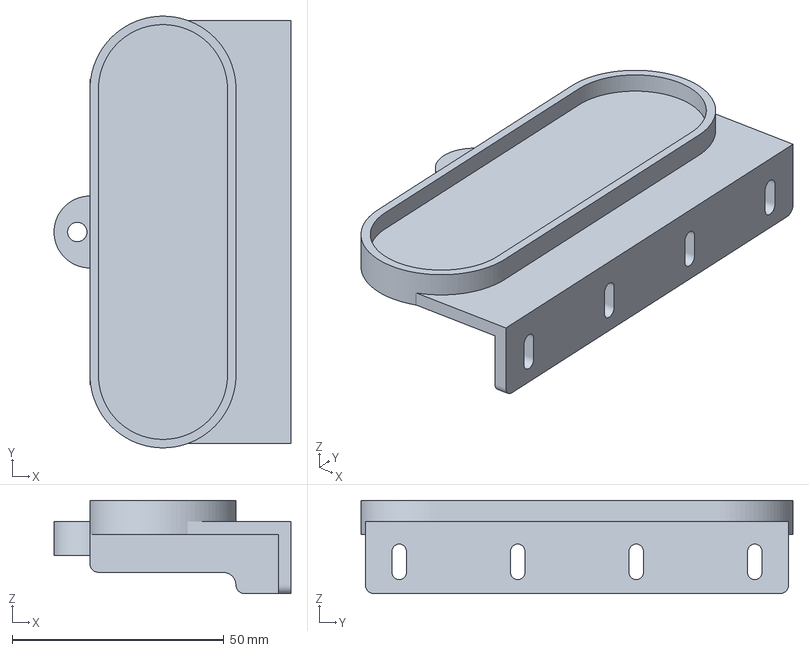
[picture p43: CAD file, 2026-06-12]
Structure/Assembly/P.3mf
56.0 x 102.0 x 22.0 mm
