MrWobot/hvps/Structure/Assembly/K.stl

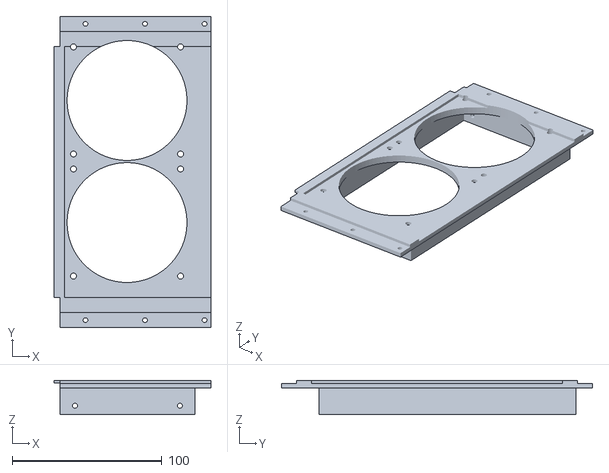
[picture p44: CAD file, 2026-06-12]
Structure/Assembly/K.stl
104.8 x 207.8 x 23.0
