MrWobot/hvps/Structure/Assembly/D.3mf

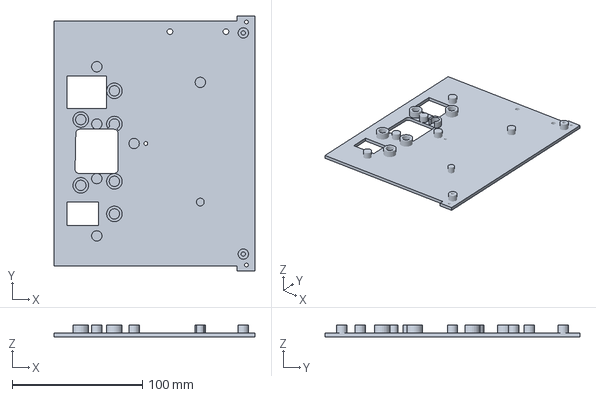
[picture p45: CAD file, 2026-06-12]
Structure/Assembly/D.3mf
154.0 x 195.8 x 9.00 mm
