MrWobot/hvps/Structure/Assembly/F.3mf

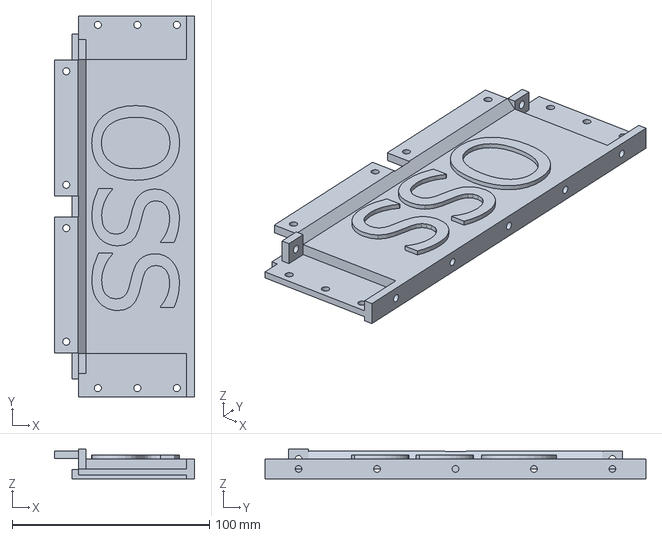
[picture p46: CAD file, 2026-06-12]
Structure/Assembly/F.3mf
71.0 x 193.0 x 15.0 mm
