MrWobot/hvps/Structure/Assembly/O.3mf

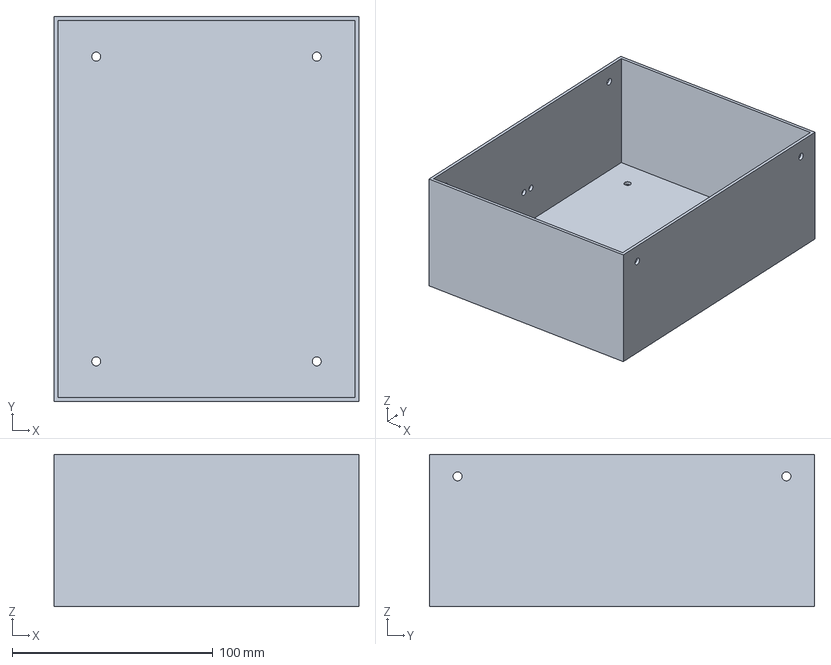
[picture p47: CAD file, 2026-06-12]
Structure/Assembly/O.3mf
152.0 x 192.0 x 76.0 mm
