MrWobot/hvps/Structure/Assembly/R.3mf

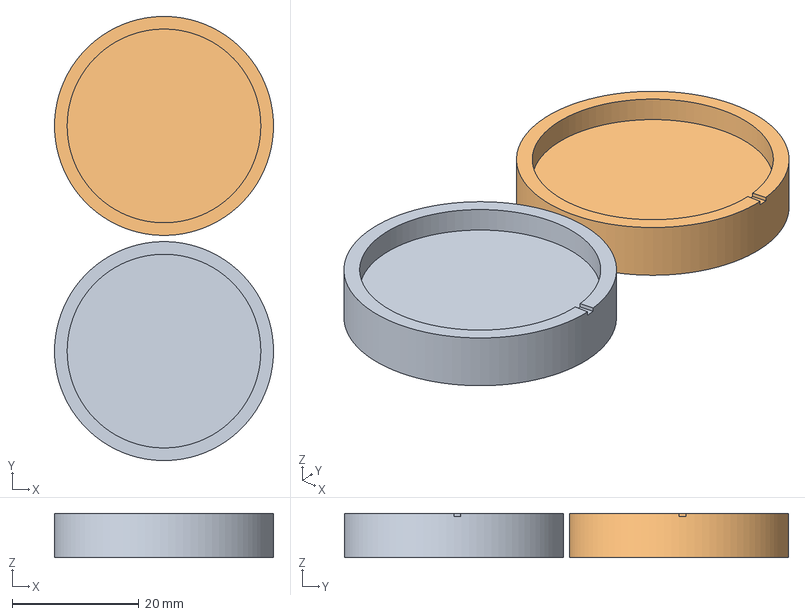
[picture p48: CAD file, 2026-06-12]
Structure/Assembly/R.3mf
34.6 x 70.2 x 7.00 mm
R.stl x 2
