MrWobot/hvps/Structure/Assembly/C.3mf

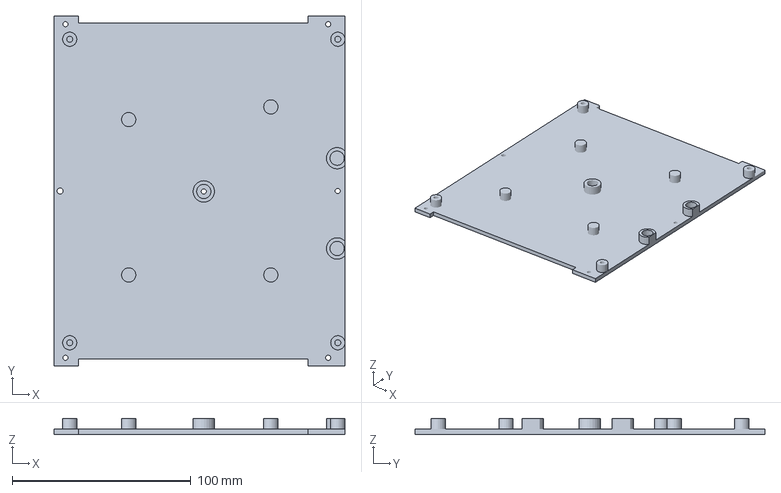
[picture p49: CAD file, 2026-06-12]
Structure/Assembly/C.3mf
162.8 x 195.8 x 9.00 mm
