MrWobot/hvps/Structure/Assembly/SoftStartResistorInsulator.3mf

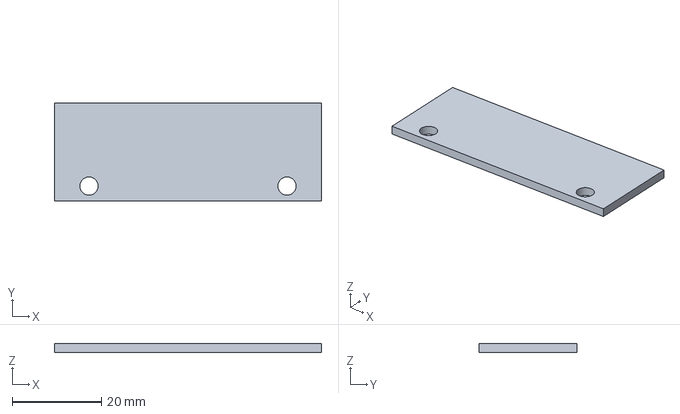
[picture p50: CAD file, 2026-06-12]
Structure/Assembly/SoftStartResistorInsulator.3mf
60.0 x 22.0 x 2.00 mm
