MrWobot/hvps/Structure/Assembly/J.3mf

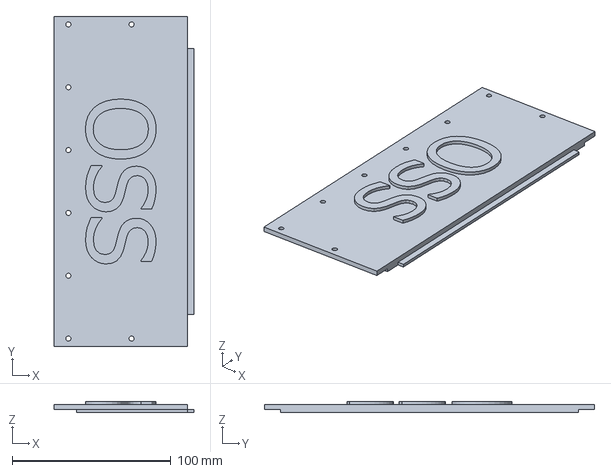
[picture p51: CAD file, 2026-06-12]
Structure/Assembly/J.3mf
88.0 x 207.8 x 7.00 mm
