MrWobot/hvps/Structure/Assembly/L.3mf

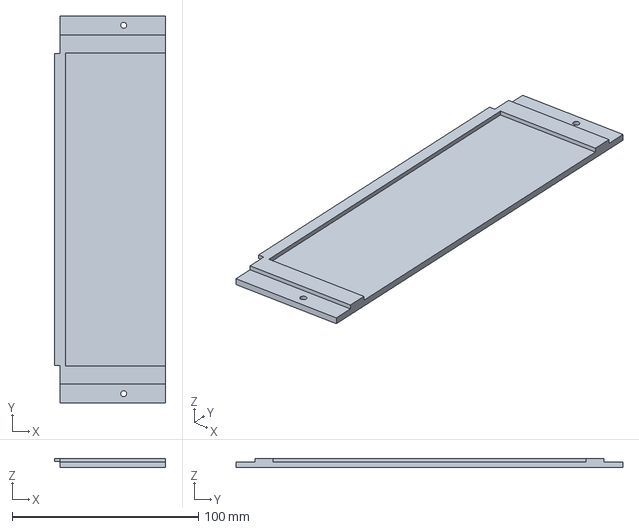
[picture p52: CAD file, 2026-06-12]
Structure/Assembly/L.3mf
59.8 x 207.8 x 5.00 mm
