MrWobot/hvps/(list of files, cad)

Other CAD files:
Structure/FlybackBobin/FindSmallestThickness_1.3mf
Structure/FlybackBobin/Bobin4.3mf
Structure/Assembly/I.3mf
Structure/FlybackBobin/FlybackBobin2.stl
Structure/FlybackBobin/Bobin2.3mf
Structure/FlybackBobin/Bobin1.3mf
Structure/FlybackBobin/FlybackBobin1HighestVoltageEnd.stl.stl
Structure/Assembly/N.3mf
Structure/FlybackBobin/FlybackBobin4.stl
Structure/FlybackBobin/FlybackSpacers.3mf
Structure/Assembly/E.stl
Structure/Assembly/X.3mf
Structure/Assembly/4KVVillardSolderingSpacers.3mf
Code/C#/FlybackModelling/Meshes/CheckingCurrentDensity.skp
Code/C#/FlybackModelling/Meshes/FlybackTransformer.skp
Code/C#/FlybackModelling/Meshes/FlybackTransformerUnexploded.skp
Code/C#/FlybackModelling/Meshes/UsingPC40_UU120X160X20.skp
Code/C#/FlybackModelling/Meshes/UsingUY30MnZnPC40130x95mm.skp
Structure/Assembly/4KVVillardSolderingSpacers.skp
Structure/Assembly/4KVVillardSolderingSpacers.stl
Structure/Assembly/4kVBobin.skp
Structure/Assembly/4kVBobin.stl
Structure/Assembly/4kVVillardsCase.skp
Structure/Assembly/4kVVillardsCase.stl
Structure/Assembly/4kVVillardsCaseLid.obj
Structure/Assembly/4kVVillardsCaseLid.skp
Structure/Assembly/4kVVillardsCaseLid.stl
Structure/Assembly/A.skp
Structure/Assembly/A.stl
Structure/Assembly/B.skp
Structure/Assembly/B.stl
Structure/Assembly/C.skp
Structure/Assembly/C.stl
Structure/Assembly/ControllerDriverBoxFrame.skp
Structure/Assembly/ControllerDriverBoxFrameNew.skp
Structure/Assembly/ControllerDriverBoxFrame_2.skp
Structure/Assembly/D.skp
Structure/Assembly/D.stl
Structure/Assembly/E.skp
Structure/Assembly/F.skp
Structure/Assembly/F.stl
Structure/Assembly/G.skp
Structure/Assembly/G.stl
Structure/Assembly/H.skp
Structure/Assembly/H.stl
Structure/Assembly/I.skp
Structure/Assembly/I.stl
Structure/Assembly/J.skp
Structure/Assembly/J.stl
Structure/Assembly/K.skp
Structure/Assembly/L.skp
Structure/Assembly/L.stl
Structure/Assembly/M.skp
Structure/Assembly/M.stl
Structure/Assembly/N.skp
Structure/Assembly/N.stl
Structure/Assembly/O.stl
Structure/Assembly/P.stl
Structure/Assembly/Q.stl
Structure/Assembly/R.skp
Structure/Assembly/R.stl
Structure/Assembly/S.skp
Structure/Assembly/S.stl
Structure/Assembly/SoftStartResistorInsulator.skp
Structure/Assembly/SoftStartResistorInsulator.stl
Structure/Assembly/T.stl
Structure/Assembly/TransformerCoreCap-0.skp
Structure/Assembly/TransformerCoreCap.skp
Structure/Assembly/TransformerCoreCap.stl
Structure/Assembly/U.stl
Structure/Assembly/V.skp
Structure/Assembly/V.stl
Structure/Assembly/W.skp
Structure/Assembly/W.stl
Structure/Assembly/WireTidy.skp
Structure/Assembly/WireTidy.stl
Structure/Assembly/X.skp
Structure/Assembly/X.stl
Structure/DummyLoadResistorsCase2/DummyLoadResistorsCase2.skp
Structure/DummyLoadResistorsCase2/DummyLoadResistorsCase2.stl
Structure/FlybackBobin/FindSmallestThickness.skp
Structure/FlybackBobin/FindSmallestThickness.stl
Structure/FlybackBobin/FindSmallestThickness_0.5.skp
Structure/FlybackBobin/FlybackBobin.skp
Structure/FlybackBobin/FlybackBobin1HighestVoltageEnd.obj
Structure/FlybackBobin/FlybackBobin1HighestVoltageEnd.skp
Structure/FlybackBobin/FlybackBobin1HighestVoltageEnd_Attempt2.skp
Structure/FlybackBobin/FlybackBobin1HighestVoltageEnd_Attempt3.skp
Structure/FlybackBobin/FlybackBobin2.skp
Structure/FlybackBobin/FlybackBobin3.skp
Structure/FlybackBobin/FlybackBobin4LowestVoltageEnd.skp
Structure/FlybackBobin/FlybackBobinBeforeMakeGroundSideThinnerToReduceLeakageInductance.skp
Structure/FlybackBobin/FlybackBobinPerfectedSimpleDesign.skp
Structure/FlybackBobin/WindingBoss.skp
Structure/FlybackBobin/WindingBoss.stl
