MrWobot/hvps/SimulationResults/_2026_06_01_22_20_01.csv

t | i | i_m | v_C
1E-07 | 0.5714285714285714 | 0 | 0
2E-07 | 1.1415107219358331 | 6.606601646695459E-05 | 0.005602240896358543
3E-07 | 1.710239213107509 | 0.00019960774436867578 | 0.016792874777920956
4E-07 | 2.2776068505284823 | 0.0004020299905928648 | 0.03355796894814782
5E-07 | 2.8436064838336925 | 0.0006747326557931478 | 0.05588350640440164
6E-07 | 3.4082310067580055 | 0.001019110716377669 | 0.08375538631791045
7E-07 | 3.9714733571850553 | 0.0014365542066402956 | 0.117159424514397
8E-07 | 4.533326517195061 | 0.0019284482010344893 | 0.15608135395536185
9E-07 | 5.093783513111613 | 0.002496172796589887 | 0.20050682522000918
1E-06 | 5.652837415547444 | 0.003141103095471642 | 0.2504214069878035
1.1E-06 | 6.2104813394491725 | 0.0038646091876825654 | 0.3058105865216464
1.2E-06 | 6.766708444141023 | 0.004668056133908105 | 0.366659770151661
1.2999999999999998E-06 | 7.321511933367533 | 0.005552803948504203 | 0.4329542837595739
1.3999999999999997E-06 | 7.874885055335237 | 0.0065202075826280605 | 0.5046793732636821
1.4999999999999996E-06 | 8.426821102753335 | 0.00757161690751184 | 0.5818202051043939
1.5999999999999995E-06 | 8.977313412873347 | 0.00870837669787934 | 0.6643618667303334
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
