MrWobot/hvps/SimulationResults/_2026_06_01_22_40_36.csv

cycle | t | i | i_m | v_C
0 | 1.00E-07 | 0.571428571 | 0 | 0
0 | 2.00E-07 | 1.141510722 | 6.61E-05 | 0.005602241
0 | 3.00E-07 | 1.710239213 | 0.000199608 | 0.016792875
0 | 4.00E-07 | 2.277606851 | 0.00040203 | 0.033557969
0 | 5.00E-07 | 2.843606484 | 0.000674733 | 0.055883506
0 | 6.00E-07 | 3.408231007 | 0.001019111 | 0.083755386
0 | 7.00E-07 | 3.971473357 | 0.001436554 | 0.117159425
0 | 8.00E-07 | 4.533326517 | 0.001928448 | 0.156081354
0 | 9.00E-07 | 5.093783513 | 0.002496173 | 0.200506825
0 | 1.00E-06 | 5.652837416 | 0.003141103 | 0.250421407
0 | 1.10E-06 | 6.210481339 | 0.003864609 | 0.305810587
0 | 1.20E-06 | 6.766708444 | 0.004668056 | 0.36665977
0 | 1.30E-06 | 7.321511933 | 0.005552804 | 0.432954284
0 | 1.40E-06 | 7.874885055 | 0.006520208 | 0.504679373
0 | 1.50E-06 | 8.426821103 | 0.007571617 | 0.581820205
0 | 1.60E-06 | 8.977313413 | 0.008708377 | 0.664361867
0 | 1.70E-06 | 9.526355368 | 0.009931827 | 0.752289367
0 | 1.80E-06 | 10.07394039 | 0.011243301 | 0.845587637
0 | 1.90E-06 | 10.62006196 | 0.01264413 | 0.94424153
0 | 2.00E-06 | 11.16471359 | 0.014135637 | 1.048235823
0 | 2.10E-06 | 11.70788883 | 0.015719141 | 1.157555214
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
