MrWobot/hvps/SimulationResults/_2026_06_01_22_48_01.csv

quarter cycle | t | V_drive | i | i_m | v_C
0 | 1E-07 | 36 | 0.5714285714285714 | 0 | 0
0 | 2E-07 | 36 | 1.1415107219358331 | 6.606601646695459E-05 | 0.005602240896358543
0 | 3E-07 | 36 | 1.710239213107509 | 0.00019960774436867578 | 0.016792874777920956
0 | 4E-07 | 36 | 2.2776068505284823 | 0.0004020299905928648 | 0.03355796894814782
0 | 5E-07 | 36 | 2.8436064838336925 | 0.0006747326557931478 | 0.05588350640440164
0 | 6E-07 | 36 | 3.4082310067580055 | 0.001019110716377669 | 0.08375538631791045
0 | 7E-07 | 36 | 3.9714733571850553 | 0.0014365542066402956 | 0.117159424514397
0 | 8E-07 | 36 | 4.533326517195061 | 0.0019284482010344893 | 0.15608135395536185
0 | 9E-07 | 36 | 5.093783513111613 | 0.002496172796589887 | 0.20050682522000918
0 | 1E-06 | 36 | 5.652837415547444 | 0.003141103095471642 | 0.2504214069878035
0 | 1.1E-06 | 36 | 6.2104813394491725 | 0.0038646091876825654 | 0.3058105865216464
0 | 1.2E-06 | 36 | 6.766708444141023 | 0.004668056133908105 | 0.366659770151661
0 | 1.2999999999999998E-06 | 36 | 7.321511933367533 | 0.005552803948504203 | 0.4329542837595739
0 | 1.3999999999999997E-06 | 36 | 7.874885055335237 | 0.0065202075826280605 | 0.5046793732636821
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
