MrWobot/hvps/Kicad/VillardCascadingSubcircuitLowVoltage/VillardCascadingSubcircuitLowVoltage.kicad_pcb

## KiCad design Kicad/VillardCascadingSubcircuitLowVoltage/VillardCascadingSubcircuitLowVoltage.kicad_pcb (2026-07-01)

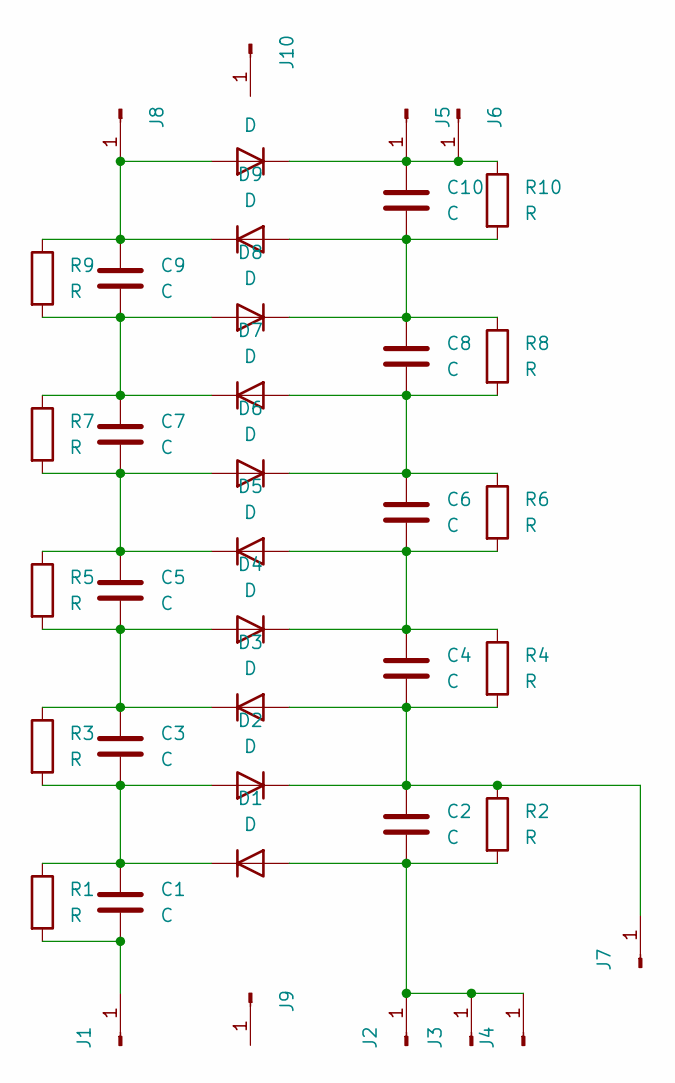
[picture p53: schematic VillardCascadingSubcircuitLowVoltage.kicad_sch]

Parts:
C1, C2, C3, C4, C5, C6, C7, C8, C9, C10: C; CBB22_125J630V
D1, D2, D3, D4, D5, D6, D7, D8, D9, D10: D; D_DO-201AD_P15.24mm_Horizontal
J1, J2, J3, J4, J5, J6, J7, J8: Conn_01x01_Pin; VersatilePad
J9, J10: Conn_01x01_Pin; M2.5Hole
R1, R2, R3, R4, R5, R6, R7, R8, R9, R10: R; R_Axial_DIN0309_L9.0mm_D3.2mm_P12.70mm_Horizontal

Connections:
unnamed: C2.2, D1.2 (A), J2.1, J3.1, J4.1, R2.2
unnamed: C1.1, C3.2, D1.1 (K), D2.2 (A), R1.1, R3.2
unnamed: C2.1, C4.2, D2.1 (K), D3.2 (A), J7.1, R2.1, R4.2
unnamed: C3.1, C5.2, D3.1 (K), D4.2 (A), R3.1, R5.2
unnamed: C4.1, C6.2, D4.1 (K), D5.2 (A), R4.1, R6.2
unnamed: C5.1, C7.2, D5.1 (K), D6.2 (A), R5.1, R7.2
unnamed: C6.1, C8.2, D6.1 (K), D7.2 (A), R6.1, R8.2
unnamed: C7.1, C9.2, D7.1 (K), D8.2 (A), R7.1, R9.2
unnamed: C8.1, C10.2, D8.1 (K), D9.2 (A), R8.1, R10.2
unnamed: C9.1, D9.1 (K), D10.2 (A), J8.1, R9.1
unnamed: C10.1, D10.1 (K), J5.1, J6.1, R10.1
unnamed: C1.2, J1.1, R1.2

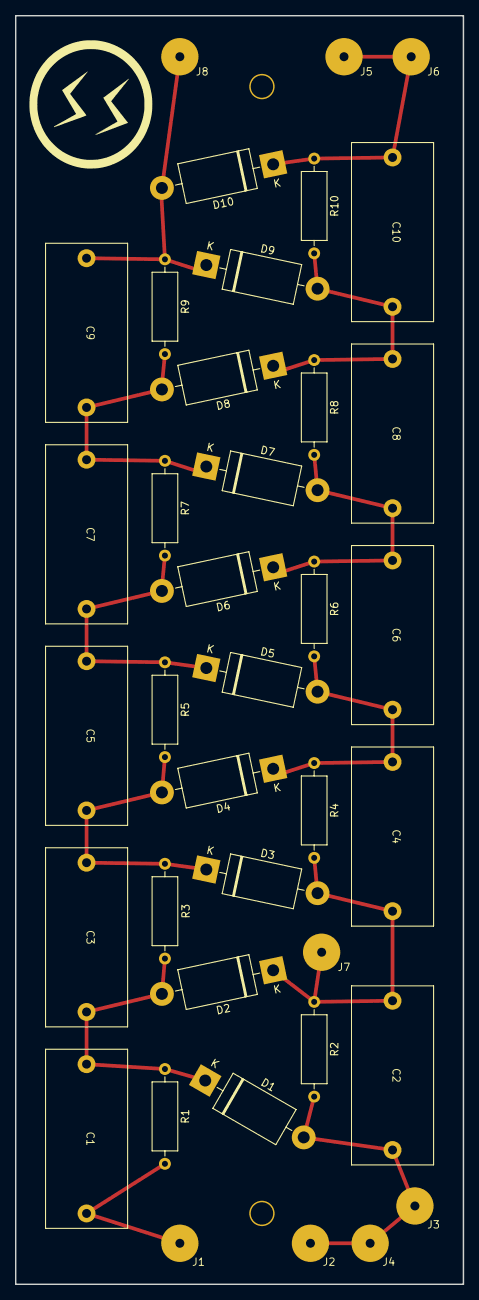
[picture p54: board VillardCascadingSubcircuitLowVoltage.kicad_pcb from above]

Board: 2 copper layers, 60.0 x 170.0 mm, 40 parts (0 on the bottom side), 12 nets.
