MrWobot/hvps/Kicad/OutputCompositeResistorSubcircuit2/OutputCompositeResistorSubcircuit2.kicad_pcb

## KiCad design Kicad/OutputCompositeResistorSubcircuit2/OutputCompositeResistorSubcircuit2.kicad_pcb (2026-06-12)

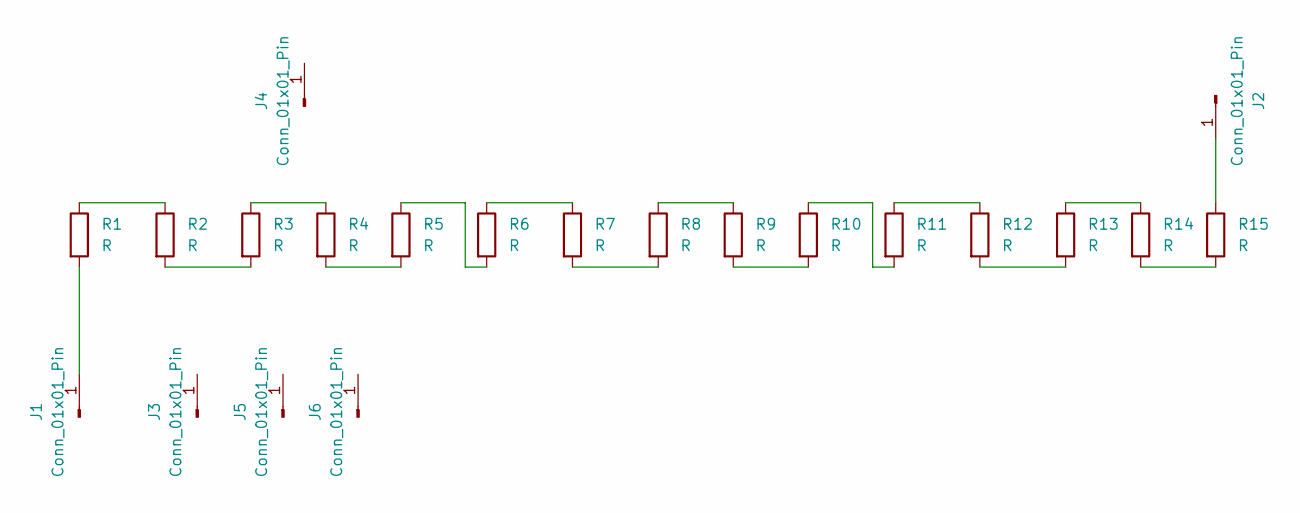
[picture p61: schematic OutputCompositeResistorSubcircuit2.kicad_sch]

Parts:
J1, J2: Conn_01x01_Pin; VersatilePad
J3, J4, J5, J6: Conn_01x01_Pin; M3Hole
R1, R2, R3, R4, R5, R6, R7, R8, R9, R10, R11, R12, R13, R14, R15: R; HVR82MY5010

Connections:
unnamed: J1.1, R1.2
unnamed: J2.1, R15.1
unnamed: R1.1, R2.1
unnamed: R2.2, R3.2
unnamed: R3.1, R4.1
unnamed: R4.2, R5.2
unnamed: R5.1, R6.2
unnamed: R6.1, R7.1
unnamed: R7.2, R8.2
unnamed: R8.1, R9.1
unnamed: R10.1, R11.2
unnamed: R9.2, R10.2
unnamed: R11.1, R12.1
unnamed: R12.2, R13.2
unnamed: R13.1, R14.1
unnamed: R14.2, R15.2

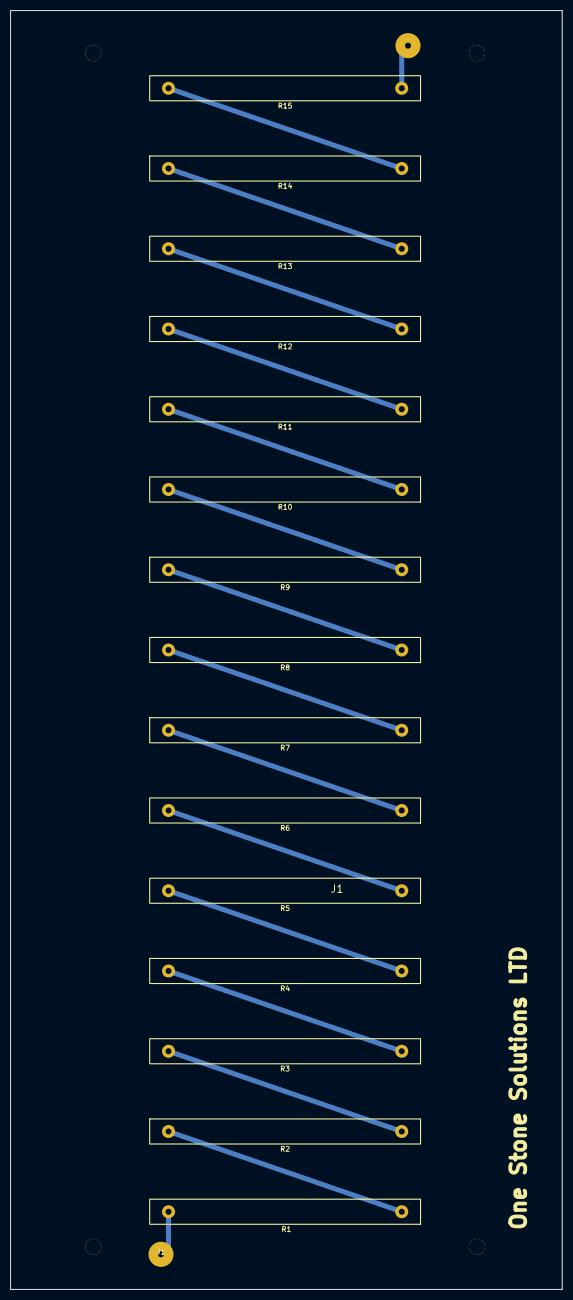
[picture p62: board OutputCompositeResistorSubcircuit2.kicad_pcb from above]

Board: 2 copper layers, 110.0 x 255.0 mm, 21 parts (0 on the bottom side), 16 nets.
