MrWobot/hvps/(commit log)

2026-06-12 new github because lost access.
    [CurrentVoltageFeedbackModule.kicad_sch, DebugAndOtherPeripheralsBoard.kicad_sch, FlybackJoiner.kicad_sch, HVPSController.kicad_sch, HVPSController2.kicad_sch, OutputCompositeResistorSubcircuit2.kicad_sch, Peripheral1.kicad_sch, ShortedSecondaryModel.kicad_sch]
2026-06-12 more of the c++
    [CheckingCurrentDensity.obj, CheckingCurrentDensity.skp, FlybackTransformer.obj, FlybackTransformer.skp, FlybackTransformerUnexploded.skp, UsingPC40_UU120X160X20.obj, UsingPC40_UU120X160X20.skp, UsingUY30MnZnPC40130x95mm.obj]
2026-06-12 getting there.
    [DummyLoadResistorsCase2.3mf, DummyLoadResistorsCase2.skp, DummyLoadResistorsCase2.stl, FlybackJoiner.kicad_sch, HVPSController.kicad_sch]
2026-06-12 and thats all of it
    [Parts_HVPSController.xlsx, Parts_HVPSController2.xlsx]
2026-07-01 C++ cleanup going good.
    [4kV.xlsx, 4kVBobin.3mf, 4kVBobin.skp, 4kVBobin.stl, 4kVVillardsCase.3mf, 4kVVillardsCase.skp, 4kVVillardsCase.stl, 4kVVillardsCaseLid.3mf]
2026-07-06 Implemented runNCycles
    FPGA error reporting and now just need to check all this and then implement capturing at a lower rate for runNCycles which atm supports up to 255 cycles with graphical feedback in the ui after.
    [4kV.xlsx]
2026-07-10 Going great, debugging villard now works!
    [4kV.xlsx, HVPSController2.kicad_sch]
