MrWobot/hvps/(notices)

Notices in the files:
Code/C#/FlybackModelling/Meshes/CheckingCurrentDensity.obj:
Exported from SketchUp, (c) 2000-2012 Trimble Navigation Limited
